FORMBOT/Marathon_UpdateManager/README.md

# Marathon Update Manager

  

Under this repository, the relevant files for successfully operating the Marathon IDEX 3D Printer are maintained and constantly updated.

- Klipper Configs
- Slicer Profiles
- Assembly and Operation Manual
- STL Files
- Official MODs and upgrades
- etc

By selecting 'update' for the 'Marathon' component from the 'Update Manager' in the Mainsail interface, all the components mentioned above will be updated and saved in the '0__Marathon' folder in your 'config' menu. 







## Enjoy and Happy Printing

Yours, Formbot Team ! :)

https://www.formbot3d.com/
