FORMBOT/Marathon_UpdateManager/2__Formbot_MODs/21__kTAMV_CXC/Mod_kTAMV_CXC___05062024.pdf

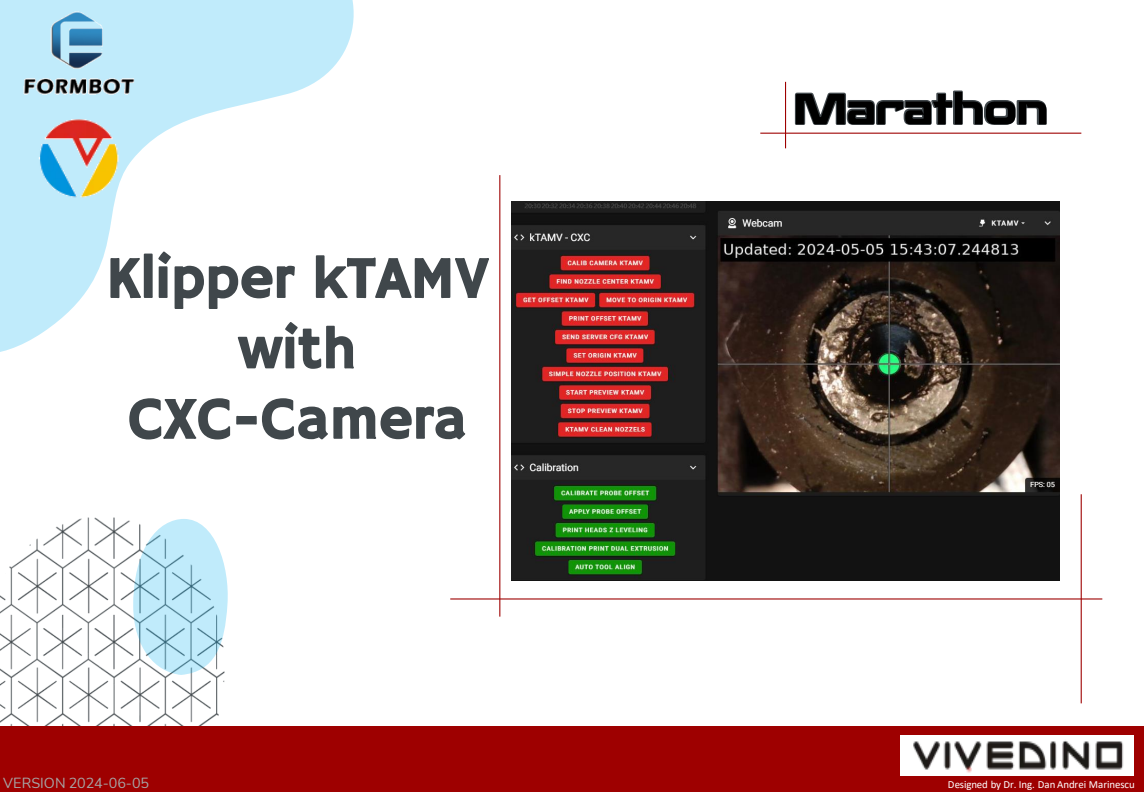
[picture p1: page 1]
VERSION 2024-06-05; Designed by Dr. Ing. Dan Andrei Marinescu; Klipper kTAMV with CXC-Camera

# Introduction

# Credits:

- CXC-Camera (https://emberprototypes.myshopify.com/products/emb02-cxc) → is an Assisted XY Calibration Tool from Ember Prototypes. (https://www.emberprototypes.com/) It was designed to be as simple and universal as possible and meant to be used on 3D printers with multiple printing heads.
- kTAMV (https://github.com/TypQxQ/kTAMV.git) → is a Klipper Alignment Tool designed by Andrei Ignat. (https://www.linkedin.com/in/andrei-ignat-718401b) It works by using Machine Vision and it allows the fully automatic calibration of nozzle offsets.
- This MOD → takes these two great products and put them together in the Marathon ecosystem.

## Why using CXC-Camera (https://emberprototypes.myshopify.com/products/emb02-cxc) ? Because … it is small … has LEDs … has a magnet … has an adjustable lens … has a long USB cable attached

… already had one laying around (as maybe some of you reading these rows also do)

## What this MOD actually is?

A highly precise and fully automatic calibration process for the XY offsets of the second printing head (T1) relative to the first one (T0).

## …and what it is not?

It is not a very fast process, it requires 6 minutes and 20 seconds to complete the calibration. However, it is significantly faster than printing multiple test model iterations.

## …. Can the calibration still be done manually?

Yes! There are only a few steps to follow. It is a process similar to what is required when using the original Windows App from Ember Prototypes.

## Known Bugs & ToDos:

-’The Auto Tool Align’ macro, when first used after a printer restart, is not aware of the Camera Calibration

## and Origin status, and it has to be restarted

-Sometimes the nozzle won’t be recognized, and the macro has to be restarted. | 1

## BOM

## - 1x CXC-Camera → https://www.emberprototypes.com/products/cxc

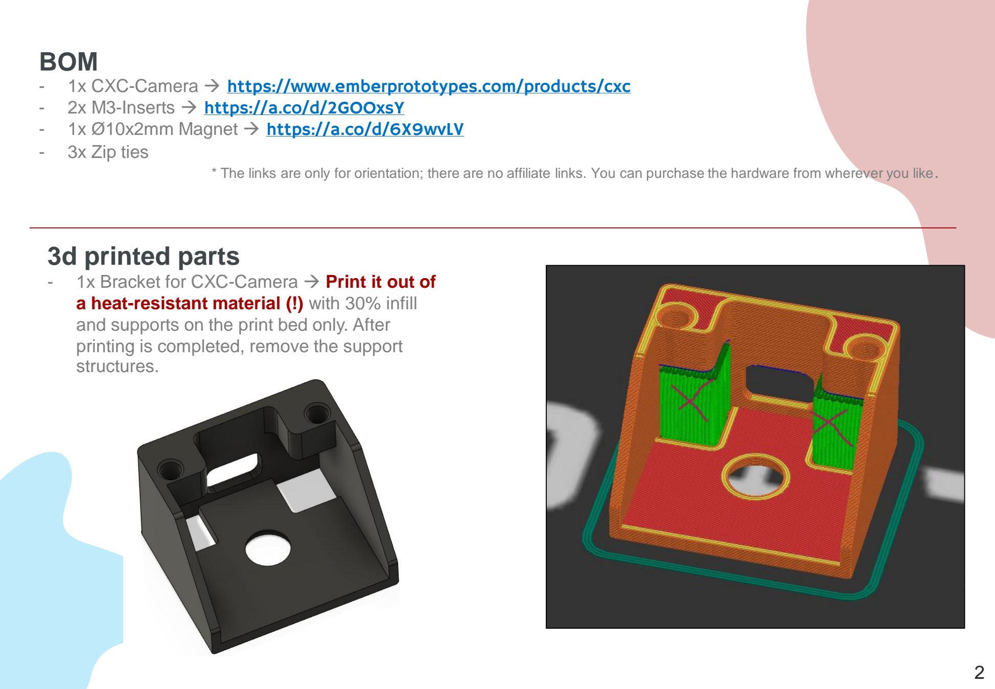
[picture p2: page 3]

## - 2x M3-Inserts → https://a.co/d/2GOOxsY - 1x Ø10x2mm Magnet → https://a.co/d/6X9wvLV

- 3x Zip ties
* The links are only for orientation; there are no affiliate links. You can purchase the hardware from wherever you like.

## 3d printed parts

- 1x Bracket for CXC-Camera → Print it out of a heat-resistant material (!) with 30% infill and supports on the print bed only. After printing is completed, remove the support structures.

## Prepare and Installation of the Bracket for the CXC-Camera

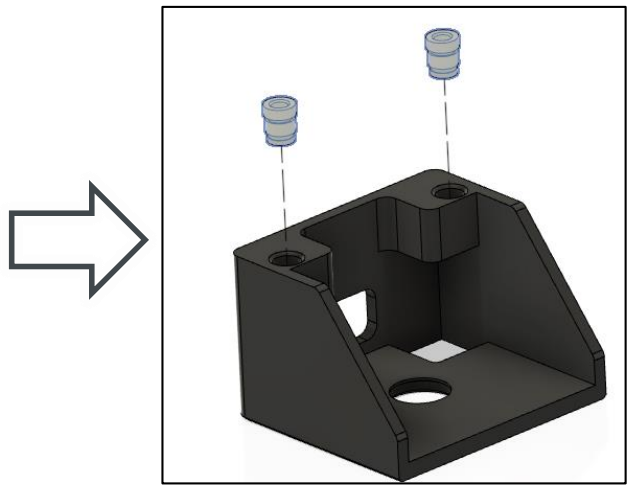
[picture p3: figure]
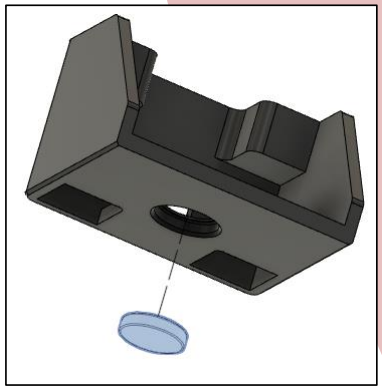
[picture p4: figure]

Install the two M3-Inserts and Ø10x2mm magnet as shown.
Make sure that the magnet orientation is such that it attracts the CXC-CAMERA !

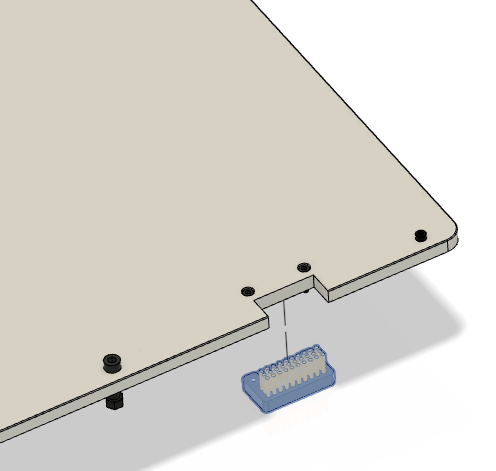
[picture p5: figure]
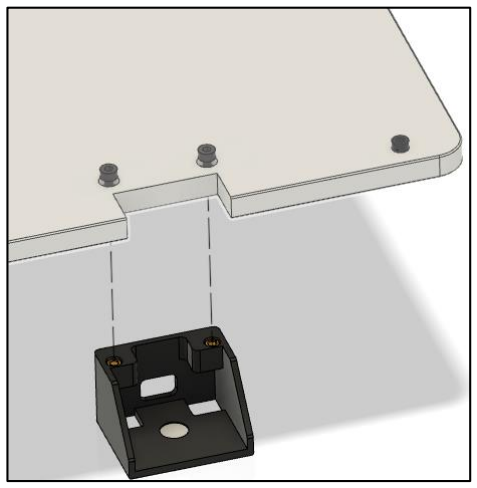
[picture p6: figure]

Remove the nozzle brush corresponding to T0 and install the Bracket for CXC-Camera in its place.
Recommendation: Keep the bed heated at 100°C for 10 minutes, and then retighten the screws holding the bracket.

## Cable management for the CXC-Camera

1

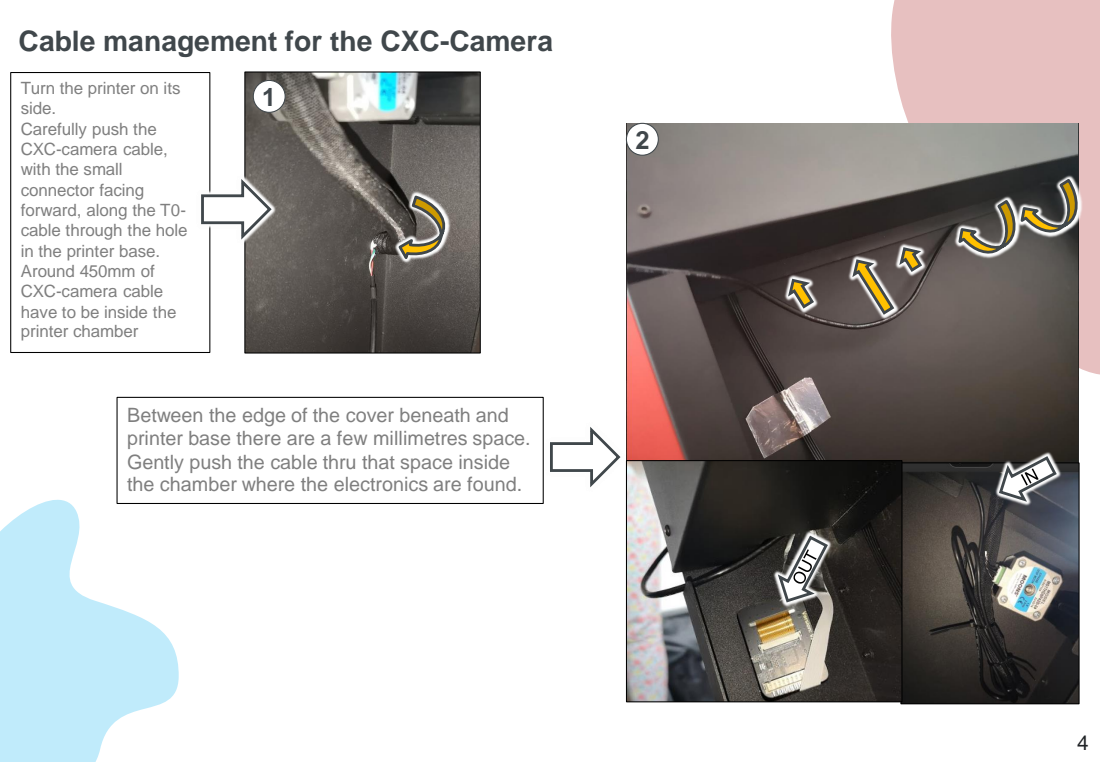
[picture p7: page 5]

Turn the printer on its
side.
Carefully push the
CXC-camera cable,
with the small
connector facing
forward, along the T0-
cable through the hole
in the printer base.
Around 450mm of
CXC-camera cable
have to be inside the
printer chamber

Between the edge of the cover beneath and
printer base there are a few millimetres space.
Gently push the cable thru that space inside
the chamber where the electronics are found.

## Cable management for the CXC-Camera

3

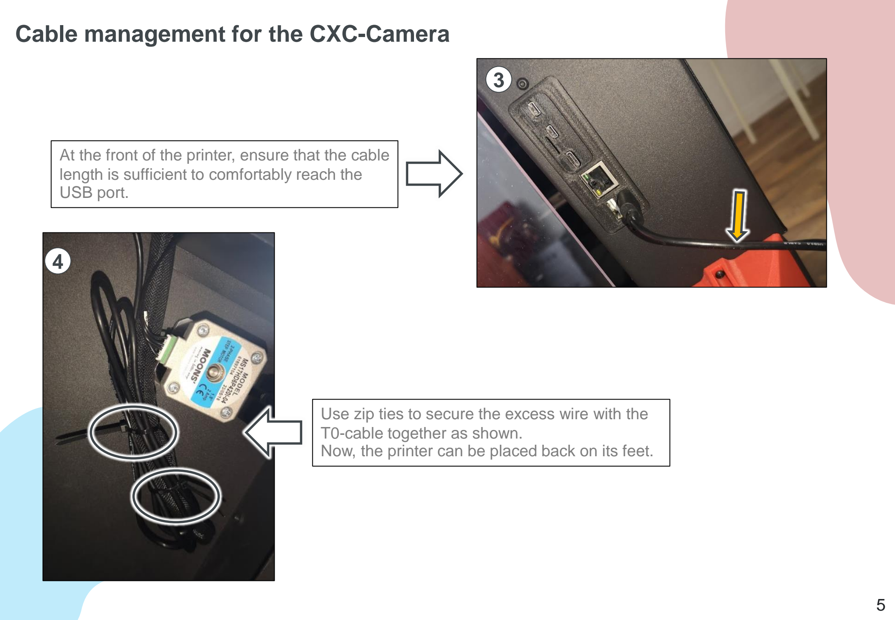
[picture p8: page 6]

At the front of the printer, ensure that the cable length is sufficient to comfortably reach the USB port.

Use zip ties to secure the excess wire with the T0-cable together as shown.
Now, the printer can be placed back on its feet.

4

## Cable management for the CXC-Camera

5

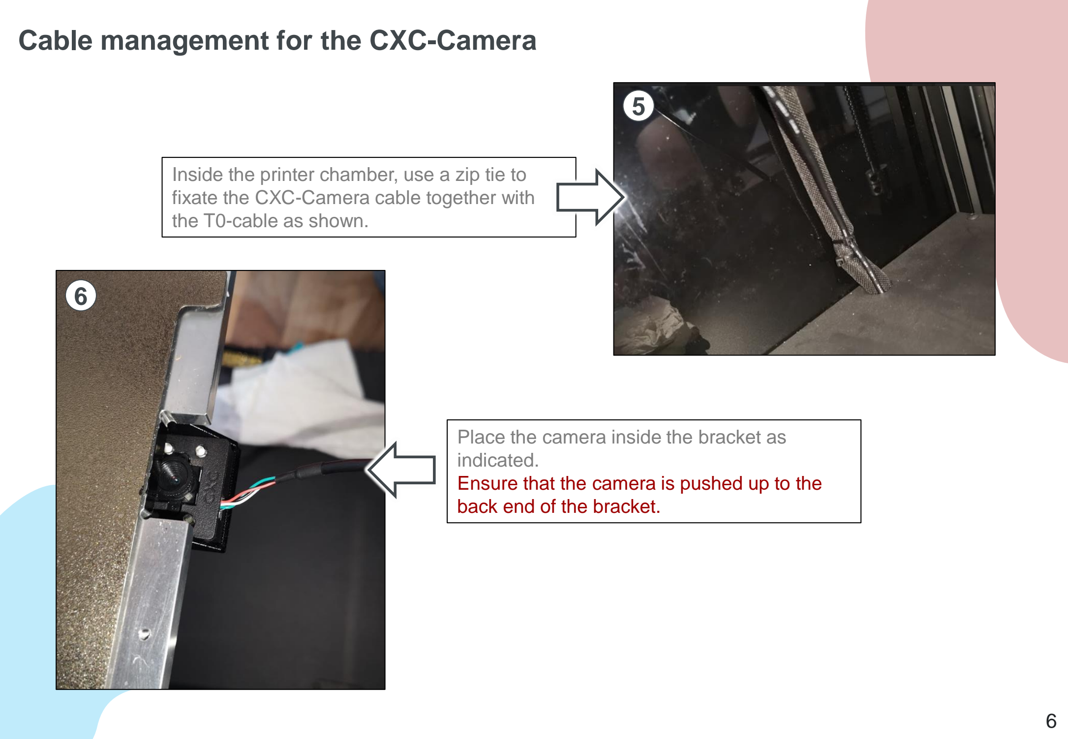
[picture p9: page 7]

Inside the printer chamber, use a zip tie to fixate the CXC-Camera cable together with the T0-cable as shown.

6

Place the camera inside the bracket as indicated.
Ensure that the camera is pushed up to the back end of the bracket.

## kTAMV Tool installation & Klipper configs

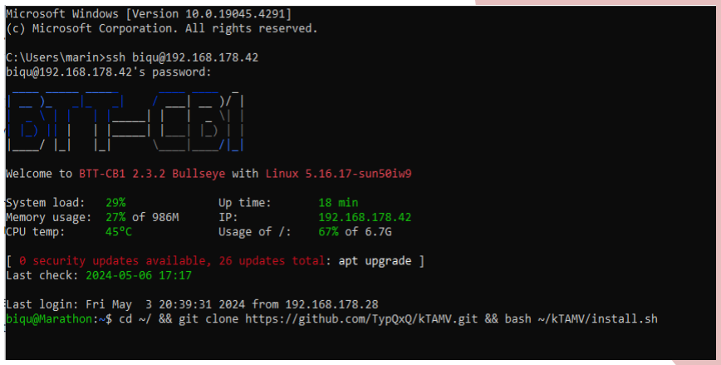
[picture p10: figure]

- Open a SSH
-connection to your printer. You can do that also from Windows Command Prompt
by typing: ssh biqu@<your printer IP> - | The password is ‘biqu’ if you haven’t change it. - | Type: cd ~/ && git clone

https://github.com/TypQxQ/kTAMV.git && bash ~/kTAMV/install.sh (https://github.com/TypQxQ/kTAMV.git%20&&%20bash%20~/kTAMV/install.sh)
- The installation will start, some question have to be answered with ‘yes’.
- During the installation your ‘printer.cfg’ and ‘moonraker.conf’ will be renamed and replaced by

new ones.
- A new file, ‘ktamv-macros.cfg’ will be added during installation to your machine
- Now some CFGs specific for Marathon have to be
added to your Machine: - | Upload the provided ‘ktamv_automation.cfg’
| and ‘variables.cfg ’
- Replace the ‘Marathon_Macros.cfg’ and ‘printer.cfg’ (The way the 'printer.cfg' resulting from

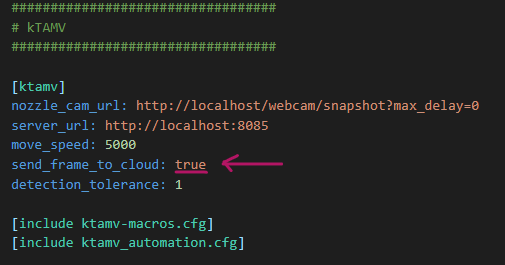
[picture p11: figure]

| the kTAMV installation is not okay, and some other settings have also been changed.)
- kTAMV is collecting data for future development, if you want to opt out, type ‘false’ in the indicated field inside ‘printer.cfg’ .

## kTAMV Tool installation & Klipper configs – Update Manager

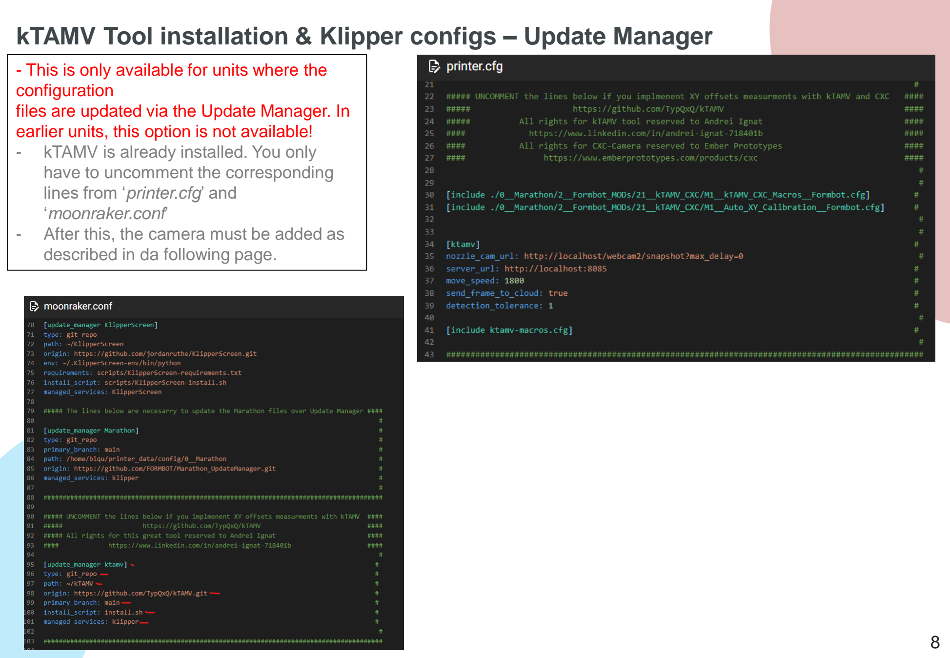
[picture p12: page 9]

- This is only available for units where the configuration
files are updated via the Update Manager. In earlier units, this option is not available!
- kTAMV is already installed. You only have to uncomment the corresponding lines from ‘printer.cfg’ and ‘moonraker.conf’
- After this, the camera must be added as described in da following page.

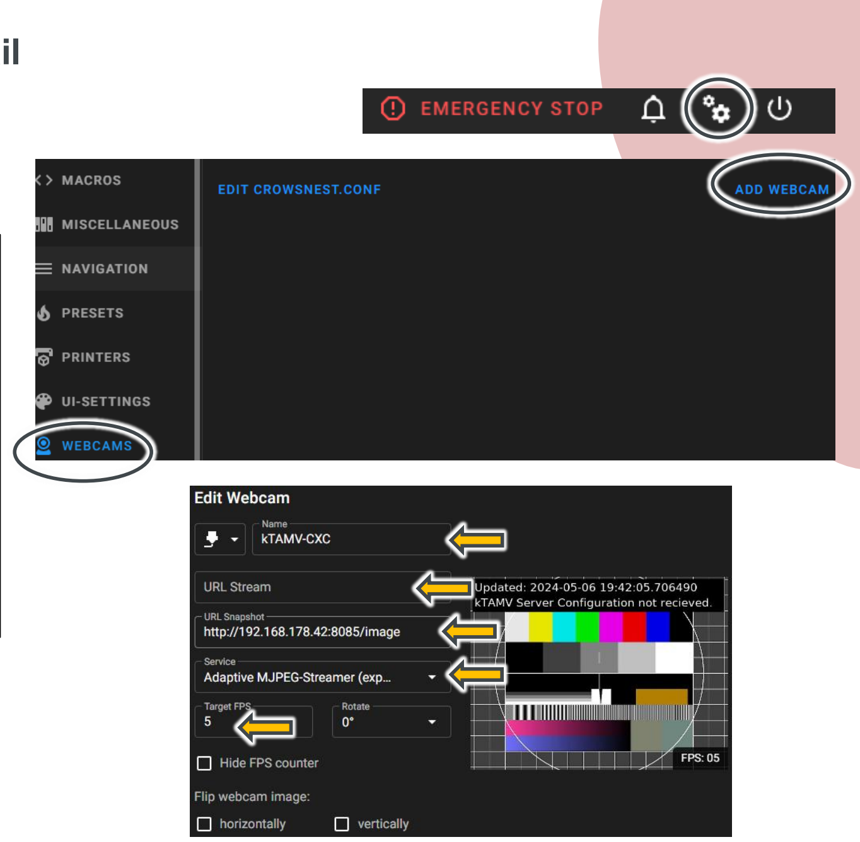
[picture p13: figure]

## Camera installation in Mainsail

- Plug in the USB-connector from the camera
- Go to ‘Interface Settings’
- Select ‘WEBCAMS’ menu
- Hit ‘ADD WEBCAM’
- Name the Camera as you prefer
- Leave ‘URL Stream’ empty
- In ‘URL Snapshot’ type: http://<your printer IP>:8085/image
- For ‘Service’ use ‘Adaptive MJPEG’
- 4-5 FPS are enough
- Power the printer OFF and than back ON from the button from behind.

## kTAMV Macros

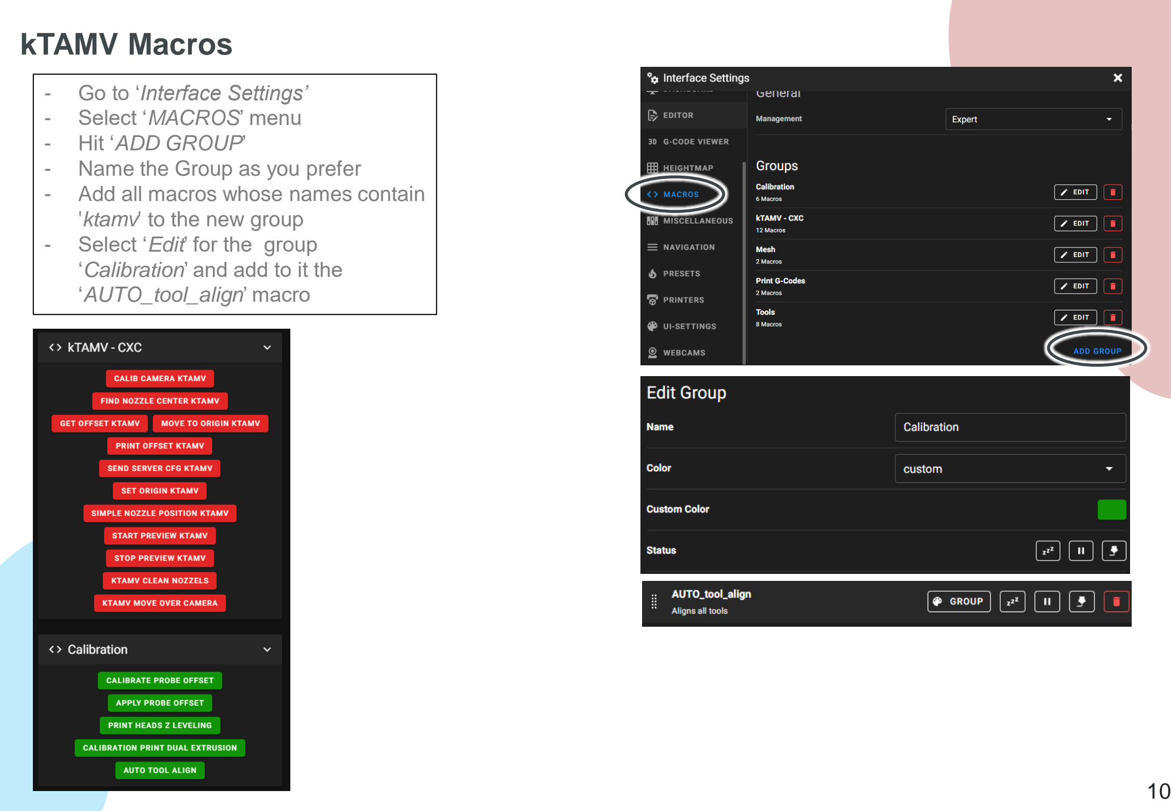
[picture p14: page 11]

- Go to ‘Interface Settings’
- Select ‘MACROS’ menu
- Hit ‘ADD GROUP’
- Name the Group as you prefer
- Add all macros whose names contain 'ktamv' to the new group
- Select ‘Edit’ for the group ‘Calibration’ and add to it the ‘AUTO_tool_align’ macro

## kTAMV Macros

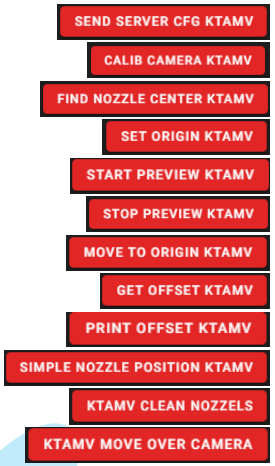
[picture p15: figure]

It sends the camera configurations to the server where kTAMV runs

It makes camera calibration, it determines the number of pixels per millimetre

It finds the nozzle centre

It sets the origin to which the next tool/tools will be calibrated

Turns the image on

Turns the image off

Moves the selected tool to the last saved origin

Measures the offsets of the selected tool relative to the saved origin

It displays in the console the offsets that were just measured

Basically checks if the camera is able to recognize the nozzle

Heats the nozzles and brush them (Marathon specific Macro)

Move the selected print head over the CXC-Camera (Marathon specific Macro)

It makes the whole determination of the T1 offsets relative to T0 automatically and saves the results in ‘variables.cfg’ ( is an adaptation of ‘ktamv_automation_example.cfg’ Macro from kTAMV made for Marathon )

## Adjust CXC Camera Lens

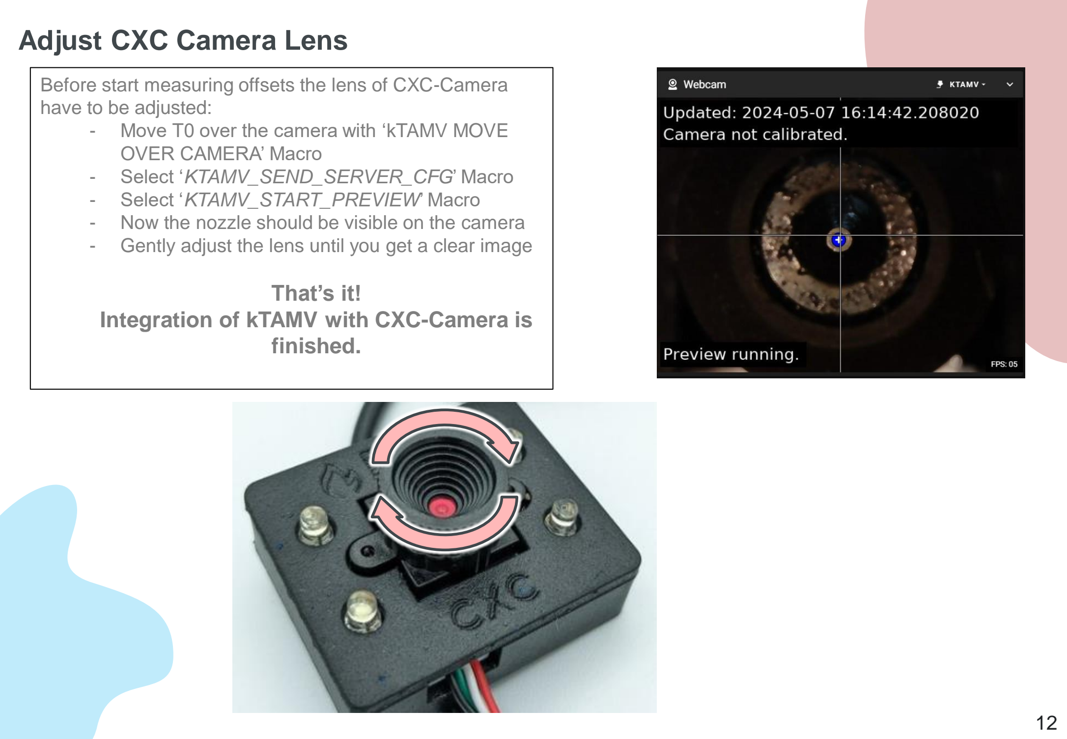
[picture p16: page 13]

Before start measuring offsets the lens of CXC-Camera have to be adjusted:
- Move T0 over the camera with ‘kTAMV MOVE OVER CAMERA’ Macro
- Select ‘KTAMV_SEND_SERVER_CFG’ Macro
- Select ‘KTAMV_START_PREVIEW’ Macro
- Now the nozzle should be visible on the camera
- Gently adjust the lens until you get a clear image

That’s it!
Integration of kTAMV with CXC-Camera is finished.

## Thoughts and concerns …

Exposure to heat → On Marathon, the CXC-
Camera has no direct contact with the bed but is exposed to radiant heat emanating from it. Theoretically, cameras like the CXC should be fine up to 70°C. However, if there are concerns about heat exposure, when not in use, the camera can be parked somewhere

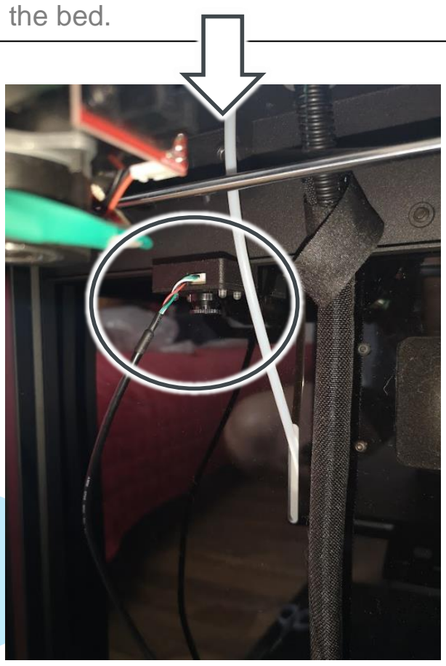
[picture p17: figure]

away from the bed.

Constantly ON → "I have no data on whether keeping the camera constantly on would prematurely wear it out. However, if there are concerns about the effects on the camera from being constantly kept on, the USB connector can be unplugged and it can be parked aside, resting on a magnet.

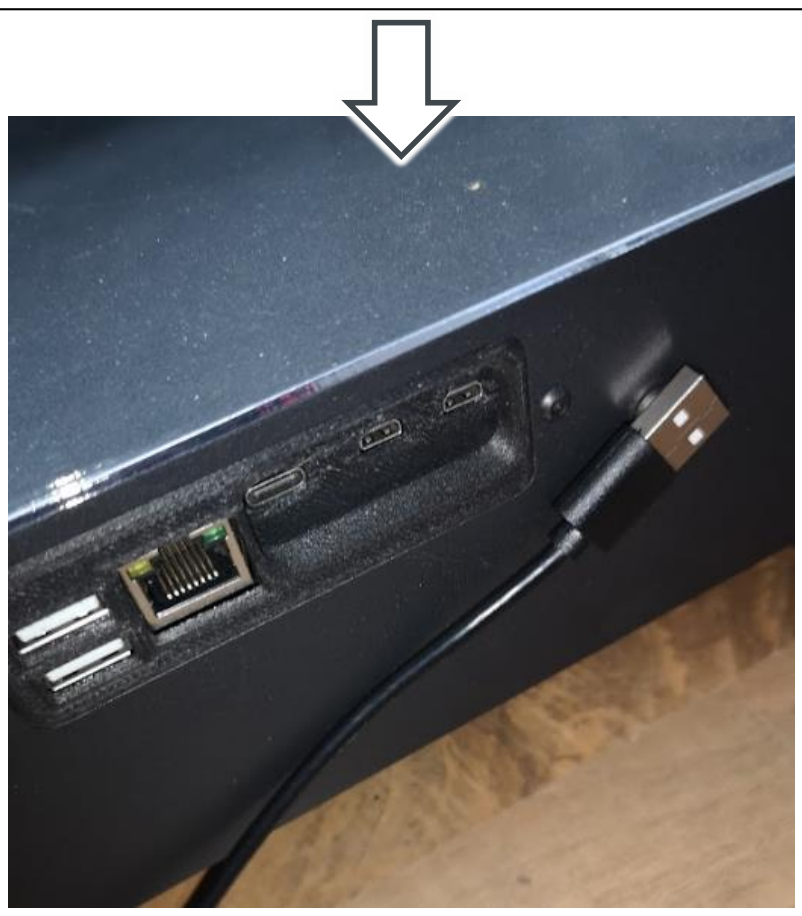
[picture p18: figure]

## Measuring the Offsets manually

kTAMV is very particular and picky when it comes to the cleanliness of the nozzles. The nozzles have to be perfectly clean in order to be detected by the kTAMV.

The measuring of the XY offsets from T1 can also be done manually in a manner very similar to the original Windows app from Ember Prototypes.

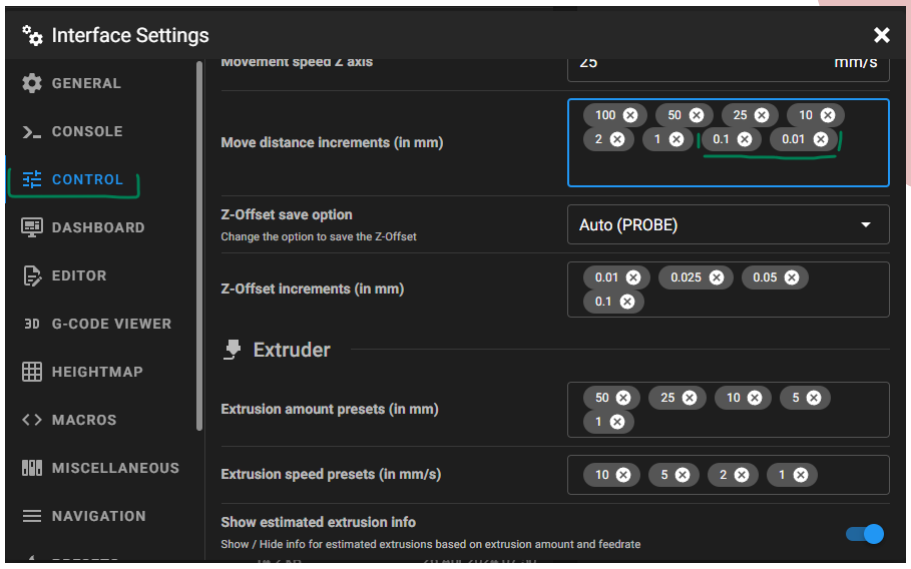
[picture p19: figure]

Make sure that in interface you have small increments:

## Measuring the Offsets manually

Make yourself an extra Macro Group like described. Execute in order the following steps to measure manually the offsets from T1:

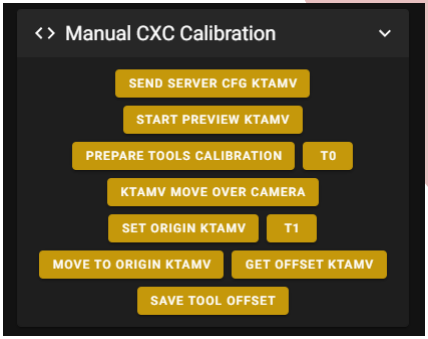
[picture p20: figure]

1. Execute ‘SEND SERVER CFG KTAMV’

→ it wakes up
the kTAMV Server
2. Execute ‘START PREVIEW KTAMV’

→ it opens the
camera
3. Execute ‘PREPARE TOOLS CALIBRATIONS’

→ it
cleans the tools, deletes the old offsets and position T0 over the camera
4. Move T0 from the interface until it is perfectly centred to the camera
5. Execute ‘SET ORIGIN KTAMV’

→ it sets the origin to
which the offsets from T1 will be measured
6. Select T1
7. Execute ‘MOVE TO ORIGIN KTAMV’

→ moves the
selected tool to origin (in this case T1

)
8. Move T1 from the interface until it is perfectly centred to the camera
9. Execute ‘GET OFFSET KTAMV’

→ it calculates the
offsets of the current tool relative to the saved Origin
10. Execute ‘SAVE TOOL OFFSET
’

→ it saves the offsets
in ‘variables.cfg
’

That is it !

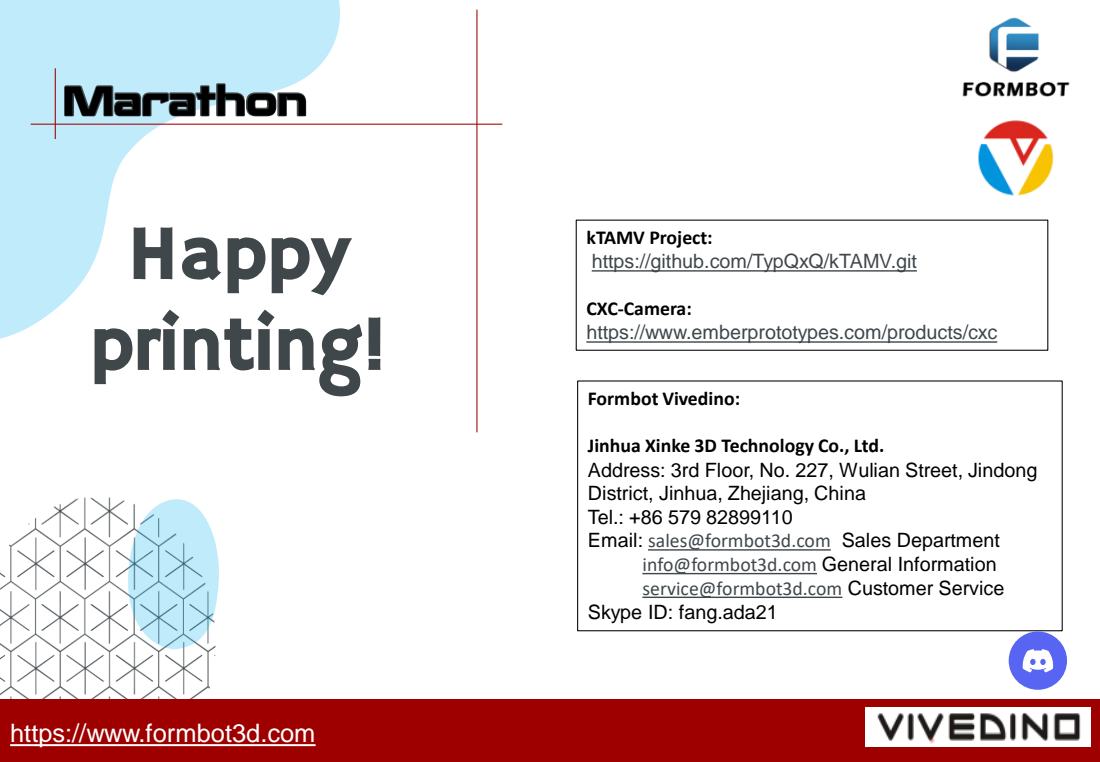
[picture p21: page 17]
Happy printing!; Formbot Vivedino:

kTAMV Project:
https://github.com/TypQxQ/kTAMV.git

CXC-Camera:
https://www.emberprototypes.com/products/cxc

Jinhua Xinke 3D Technology Co., Ltd.
Address: 3rd Floor, No. 227, Wulian Street, Jindong
District, Jinhua, Zhejiang, China
Tel.: +86 579 82899110
Email: sales@formbot3d.com Sales Department
info@formbot3d.com General Information
service@formbot3d.com Customer Service
Skype ID: fang.ada21

https://www.formbot3d.com
