FORMBOT/Marathon_UpdateManager/2__Formbot_MODs/23__MB_Fan/Mod_MB_Controlles_Fan____22062024.pdf

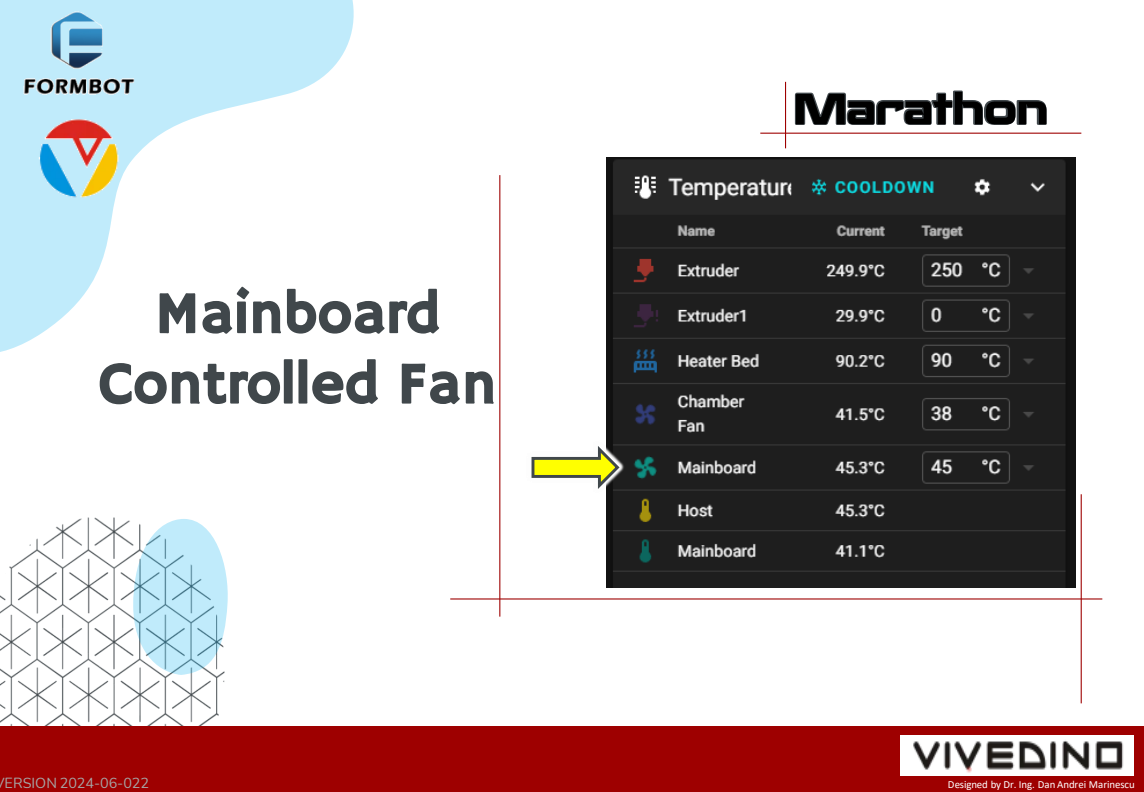
[picture p22: page 1]
VERSION 2024-06-022; Designed by Dr. Ing. Dan Andrei Marinescu; Mainboard Controlled Fan

# Introduction

# Motivation

The mainboard fan is by default always on, even when there is no printing job ongoing. As a result, the machine is unnecessarily noisy when idle.

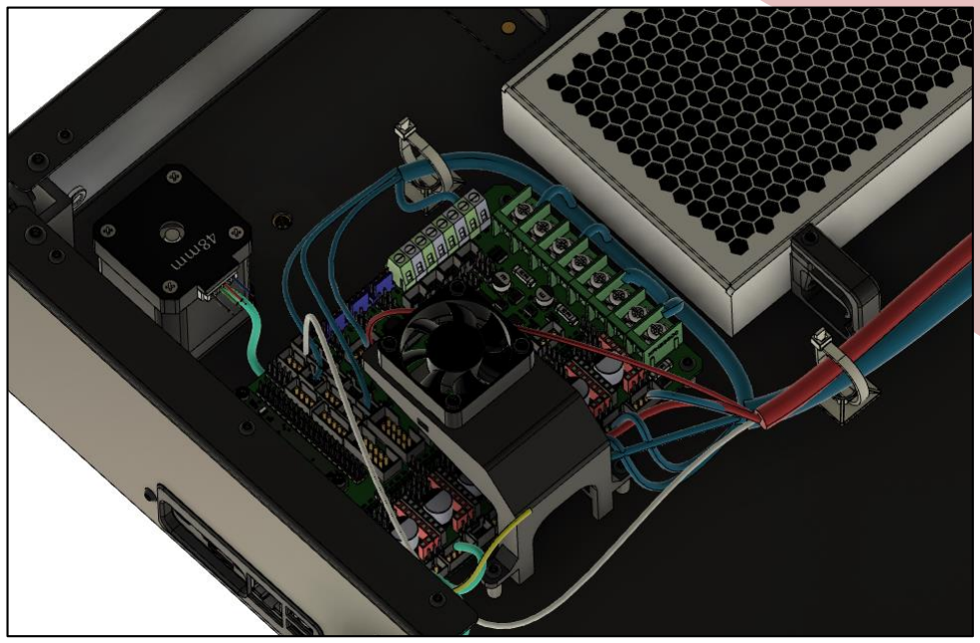
[picture p23: figure]

# Pros: It reduces the overall noise of the printer, making it completely silent when

idle.

# Cons: couldn’t find any…

## BOM

- Some 24 gauge wires.
- Cable End Sleeves

## 3d printed parts

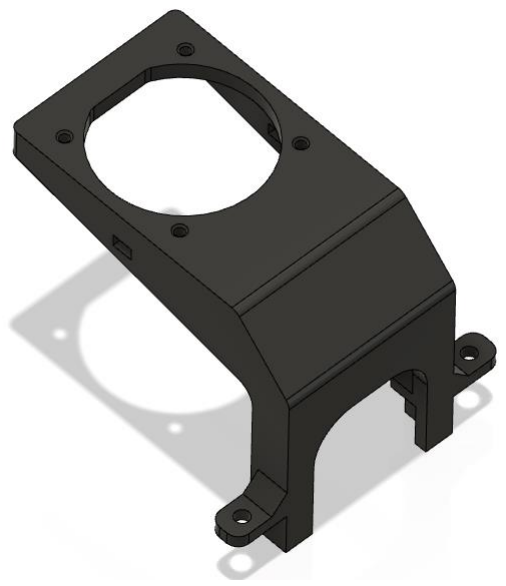
[picture p24: figure]

- 1x Bracket for the fan → with 30% infill, no supports. Chose the material and color you like.

* Print this part only if your printer doesn’t have it, in the early units was another type of bracket installed.

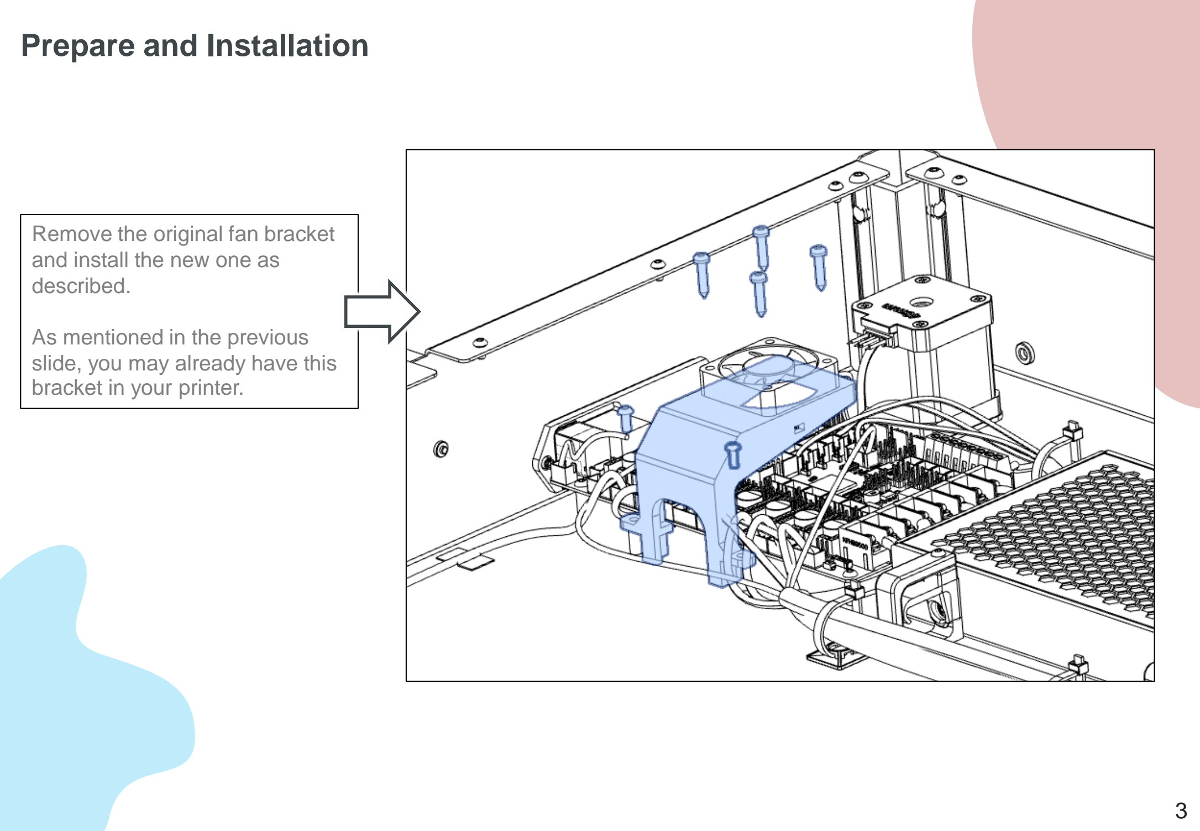
[picture p25: figure]
Prepare and Installation; Remove the original fan bracket and install the new one as described.; As mentioned in the previous slide, you may already have this bracket in your printer.

2

3

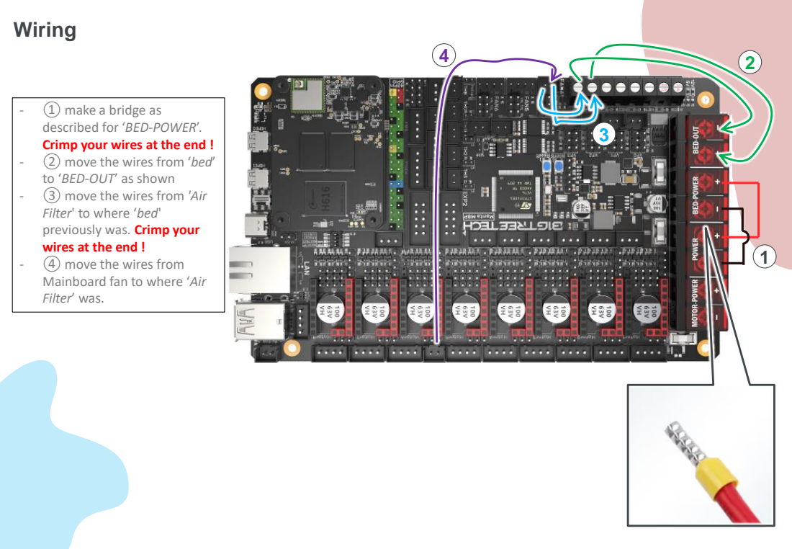
[picture p26: page 5]
Wiring -; ① make a bridge as; -POWER’.

described for ‘BED
Crimp your wires at the end !
② move the wires from ‘bed’
to ‘BED
③ move the wires from 'Air
Filter' to where ‘bed'
previously was. Crimp your
wires at the end !
④ move the wires from
Mainboard fan to where ‘Air
Filter’ was.

-OUT’ as shown

## Software settings

Go in ‘Marathon_BTT_M8P-V1.1.cfg’ and make the following changes:

- Change the heater pin for the bed: [heater_bed]
heater_pin:PB7
- Change the pin for the chamber fan: [temperature_fan chamber_fan] pin:PE1

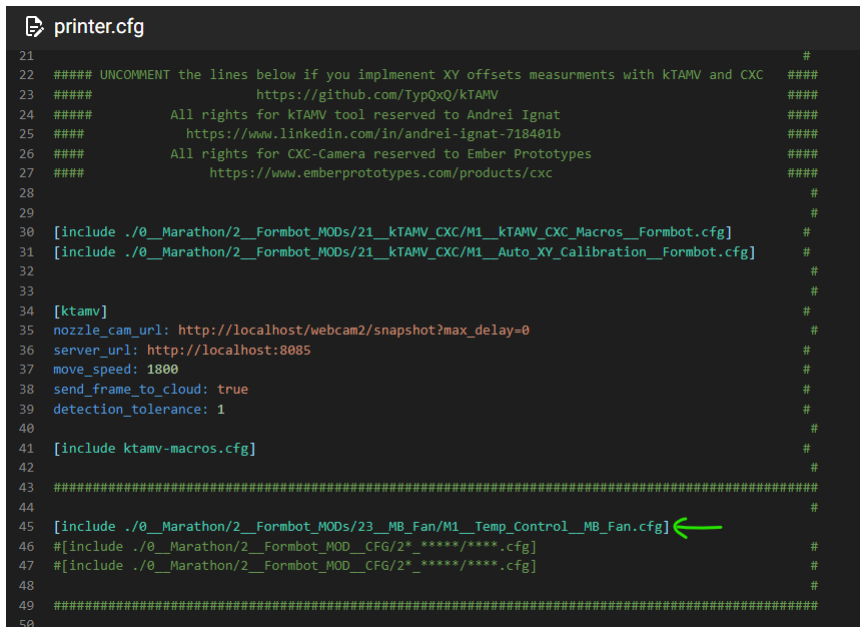
[picture p27: figure]

Add the following config section for the mainboard fan:

[temperature_fan Mainboard] pin:PE4
max_power:1.0
control:watermark
max_delta:2
sensor_type:temperature_host min_temp:0
max_temp:65
target_temp:45

If your running the new image where everything is updated via ‘Update Manager’:

- Make sure that you have all the Klipper components updated.
- Add this line in your printer.cfg in MODs CFG section

[include
./0__Marathon/2__Formbot_MODs/23__MB_Fan/M1__Temp_Cont rol__MB_Fan.cfg]

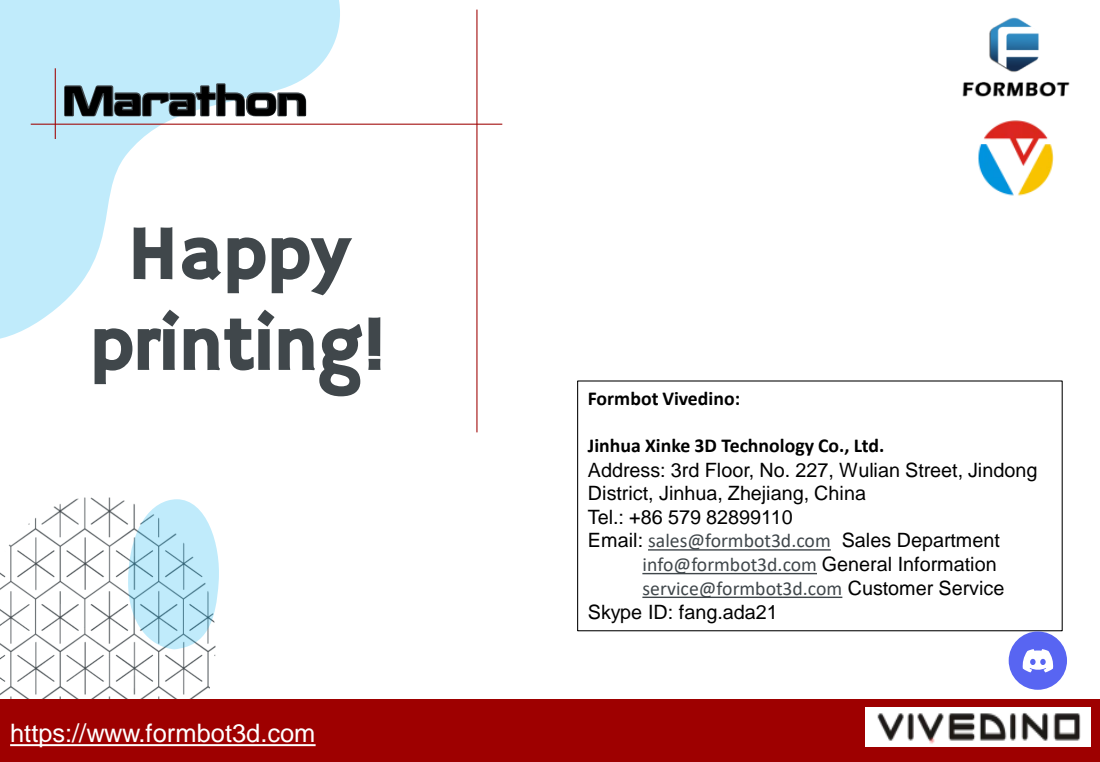
[picture p28: page 7]
Happy printing!; Formbot Vivedino:

Jinhua Xinke 3D Technology Co., Ltd.
Address: 3rd Floor, No. 227, Wulian Street, Jindong
District, Jinhua, Zhejiang, China
Tel.: +86 579 82899110
Email: sales@formbot3d.com Sales Department
info@formbot3d.com General Information
service@formbot3d.com Customer Service
Skype ID: fang.ada21

https://www.formbot3d.com
