FORMBOT/Marathon_UpdateManager/2__Formbot_MODs/22__BTT_HDMI5/Mod_BTT_HDMI5____07062024.pdf

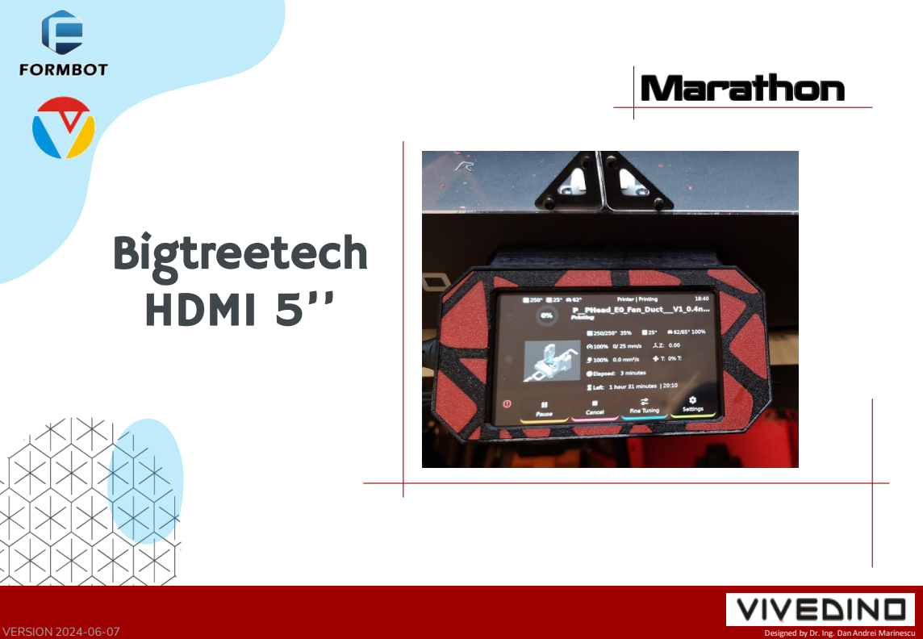
[picture p29: page 1]
VERSION 2024-06-07; Designed by Dr. Ing. Dan Andrei Marinescu; Bigtreetech HDMI 5’’

# Introduction

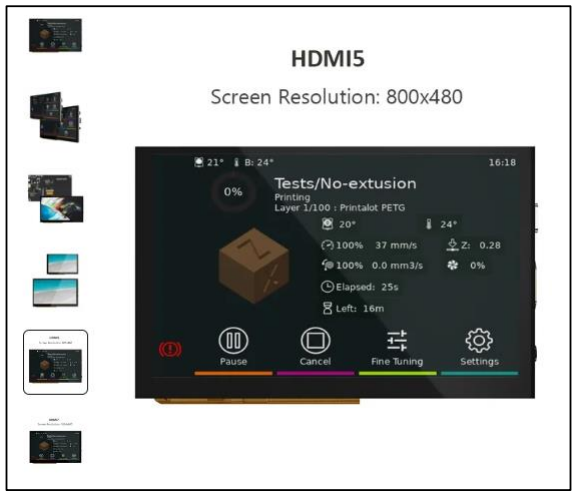
[picture p30: figure]

## https://a.aliexpress.com/_EzKYAax

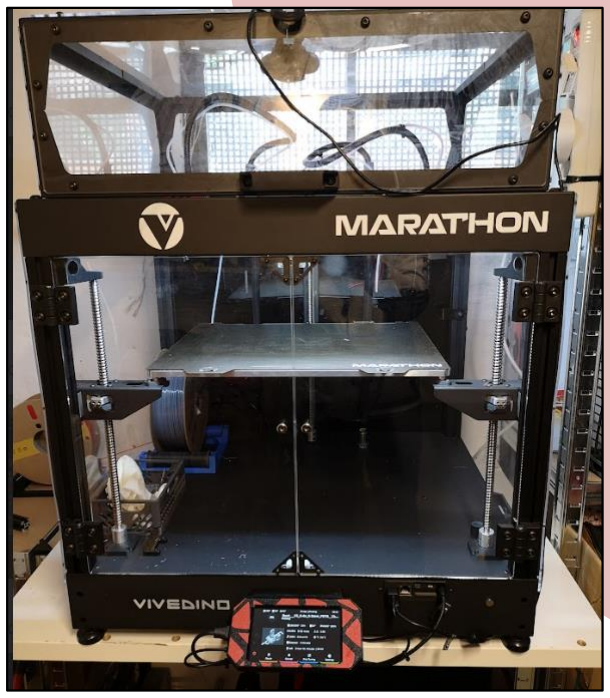
[picture p31: figure]

# Motivation

Klipper printers mainly rely on the Mainsail interface for controlling the printer. Marathon printers come standard equipped with an SPI display that allows for control of the printer and offline printing via USB stick, completely independent of the Mainsail interface.

The SPI display is relatively small, and its performance is modest. Some users would like to have a more robust solution when it comes to the display controller.

HDMI displays from Bigtreetech are perfectly compatible with Marathon electronics since they are also from Bigtreetech.

# Pros: Improved user experience Cons: You end up with some cables in plain sight

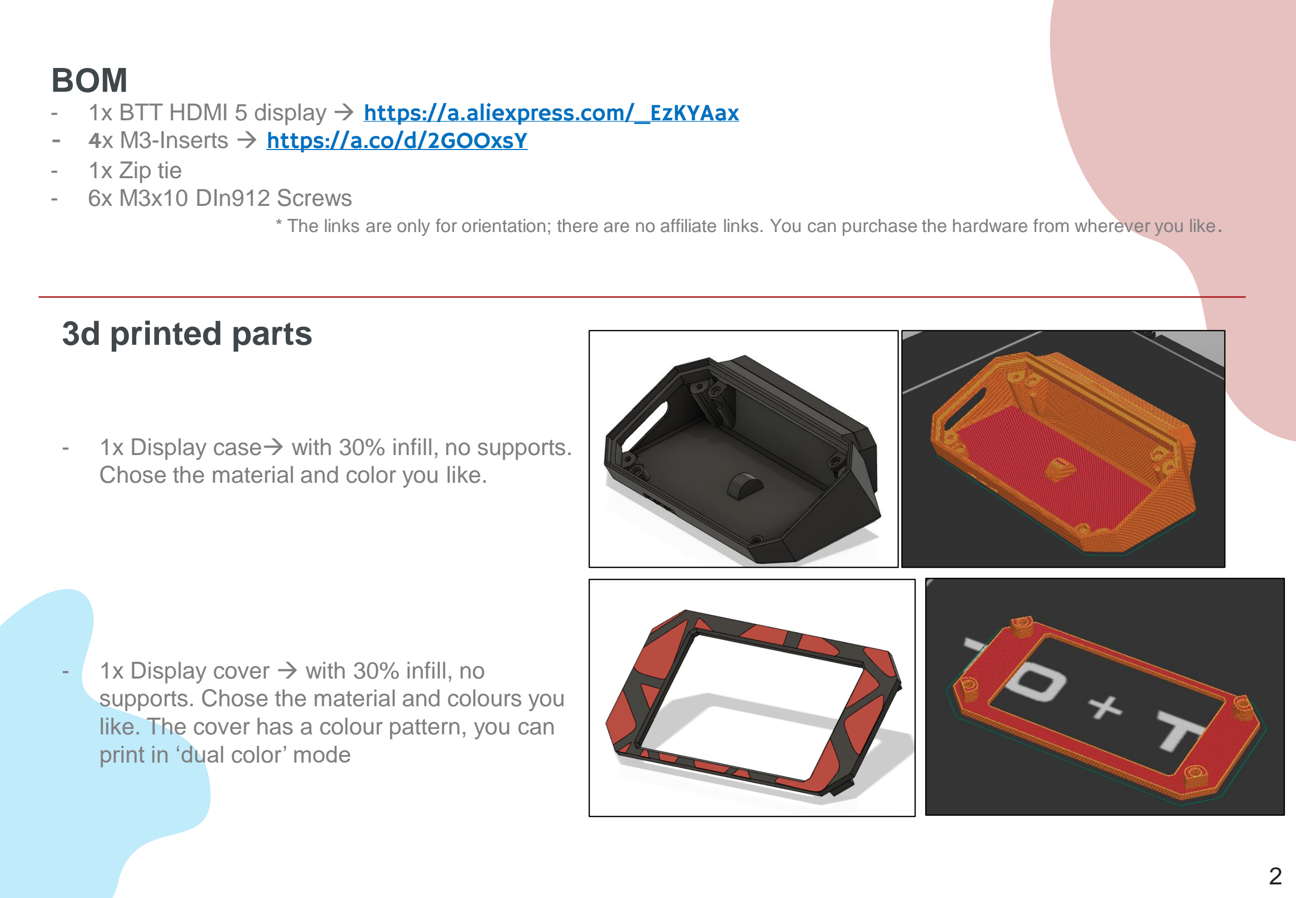
[picture p32: figure]
BOM; - 1x Zip tie - 6x M3x10 DIn912 Screws; 3d printed parts; Chose the material and color you like.; print in ‘dual color’ mode

## - 1x BTT HDMI 5 display → https://a.aliexpress.com/_EzKYAax - 4x M3-Inserts → https://a.co/d/2GOOxsY

* The links are only for orientation; there are no affiliate links. You can purchase the hardware from wherever you like.

- 1x Display case→ with 30% infill, no supports.
- 1x Display cover → with 30% infill, no supports. Chose the material and colours you like. The cover has a colour pattern, you can

## Prepare and Installation

1

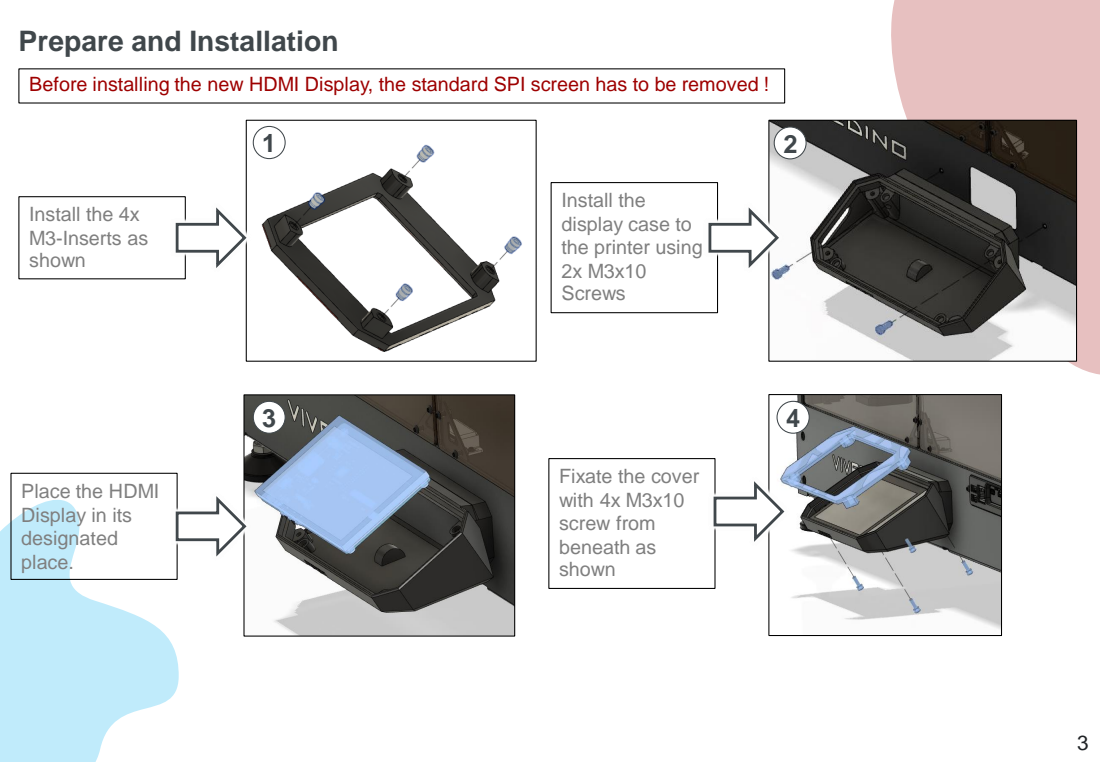
[picture p33: page 4]
Install the 4x M3-Inserts as shown

Before installing the new HDMI Display, the standard SPI screen has to be removed !

Install the
display case to
the printer using
Screws

Fixate the cover
with 4x M3x10
screw from
beneath as
shown

Place the HDMI
Display in its
designated
place.

## Cables connection

s

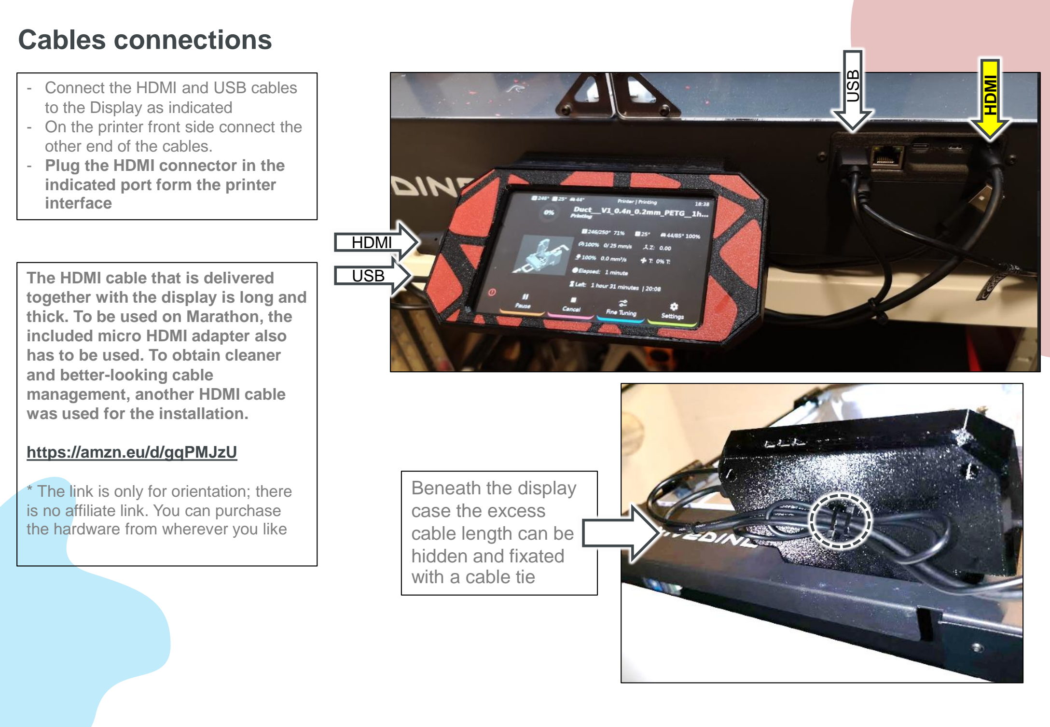
[picture p34: page 5]

HDMI

USB

USB

HDMI

- Connect the HDMI and USB cables to the Display as indicated
- On the printer front side connect the other end of the cables.
- Plug the HDMI connector in the indicated port form the printer interfac

e

The HDMI cable that is delivered together with the display is long and thick. To be used on Marathon, the included micro HDMI adapter also has to be used. To obtain cleaner and better

-looking cable
management, another HDMI cable was used for the installation.

https://amzn.eu/d/gqPMJzU

* The link is only for orientation; there is no affiliate link. You can purchase the hardware from wherever you like

Beneath the display
case the excess
cable length can be
hidden and fixated
with a cable tie

## Software settings

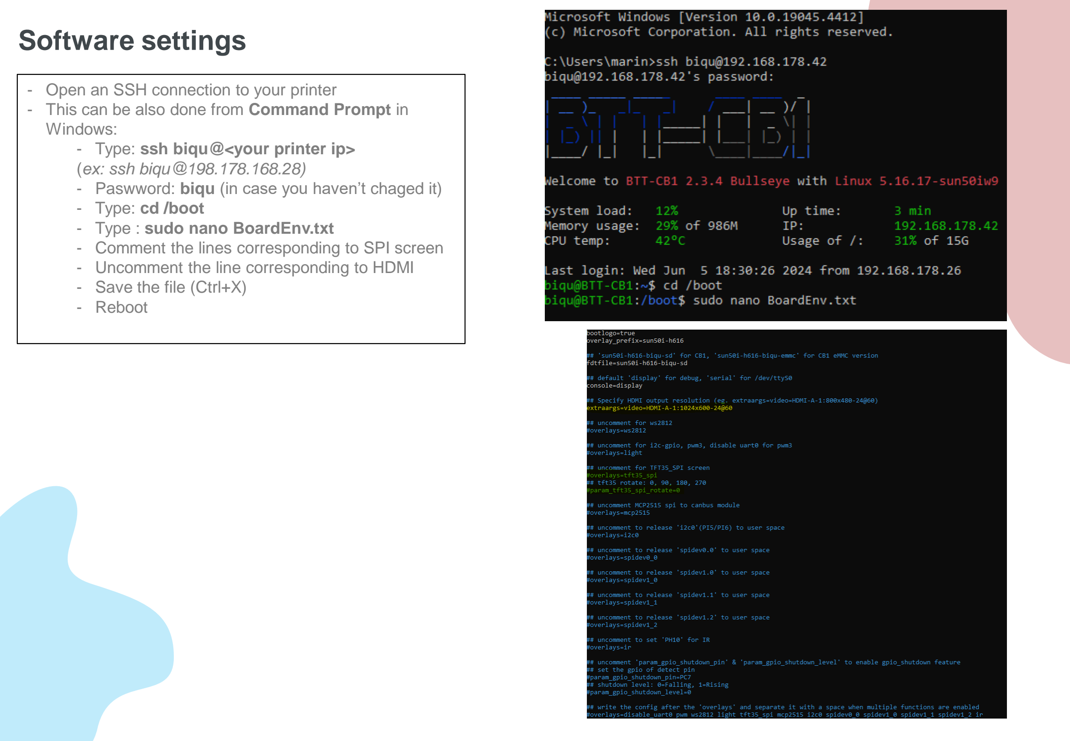
[picture p35: page 6]

- Open an SSH connection to your printer
- This can be also done from Command Prompt in Windows:
- Type: ssh biqu@<your printer ip>
(ex: ssh biqu@198.178.168.28)
- Paswword: biqu (in case you haven’t chaged it)
- Type: cd /boot
- Type : sudo nano BoardEnv.txt
- Comment the lines corresponding to SPI screen
- Uncomment the line corresponding to HDMI
- Save the file (Ctrl+X)
- Reboot

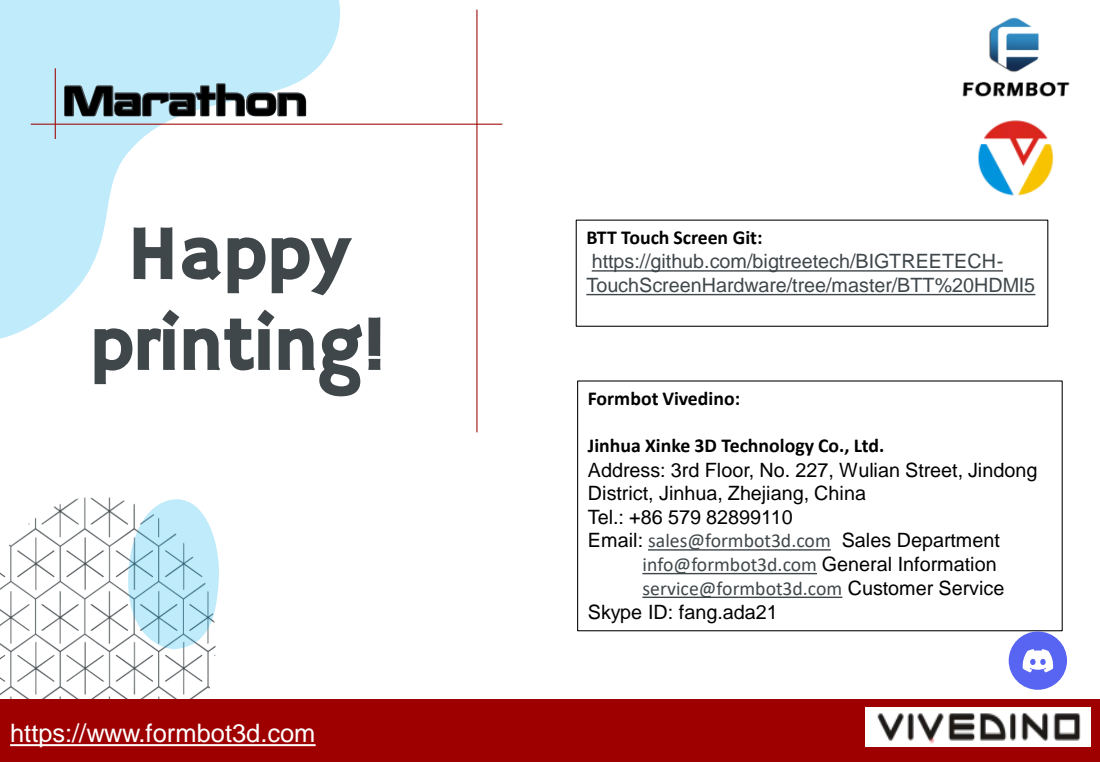
[picture p36: page 7]
Happy printing!; Formbot Vivedino:

BTT Touch Screen Git:
https://github.com/bigtreetech/BIGTREETECH-
TouchScreenHardware/tree/master/BTT%20HDMI5

Jinhua Xinke 3D Technology Co., Ltd.
Address: 3rd Floor, No. 227, Wulian Street, Jindong
District, Jinhua, Zhejiang, China
Tel.: +86 579 82899110
Email: sales@formbot3d.com Sales Department
info@formbot3d.com General Information
service@formbot3d.com Customer Service
Skype ID: fang.ada21

https://www.formbot3d.com
