FORMBOT/Marathon_UpdateManager/2__Formbot_MODs/23__MB_Fan/M1B__Fix_Fan_Mainboard___V2.0 v6.step

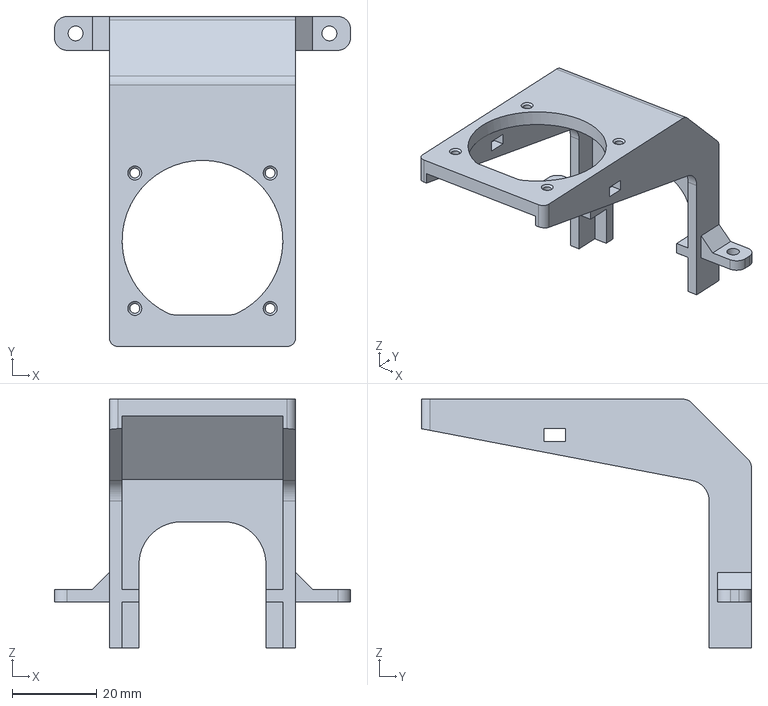
[picture p37: CAD file, 2024-06-22]
2__Formbot_MODs/23__MB_Fan/M1B__Fix_Fan_Mainboard___V2.0 v6.step
70.0 x 78.0 x 58.8 mm
