FORMBOT/Marathon_UpdateManager/2__Formbot_MODs/21__kTAMV_CXC/025_01__MB1__Fix_CXC_Bed___V1.0 v17.step

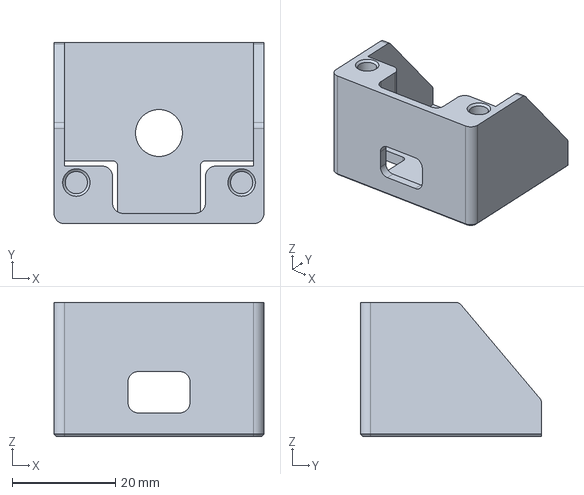
[picture p38: CAD file, 2024-05-28]
2__Formbot_MODs/21__kTAMV_CXC/025_01__MB1__Fix_CXC_Bed___V1.0 v17.step
40.6 x 35.1 x 26.0 mm
