FORMBOT/Marathon_UpdateManager/3__Formbot_SlicerProfiles/31__PrusaSlicer/01_01082024/printer/STL_Marathon_BED_Mono_Dual.stl

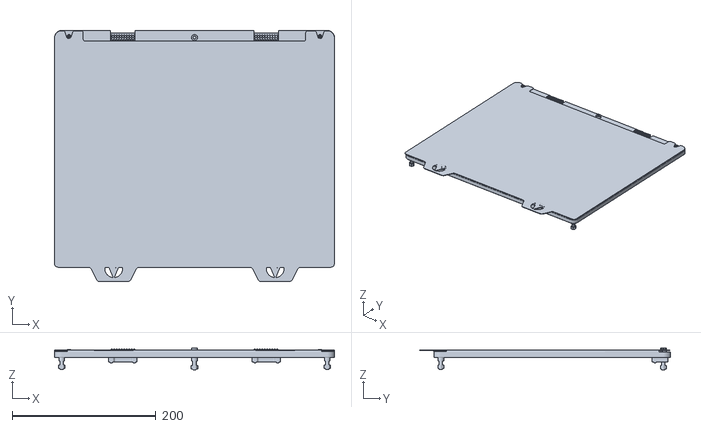
[picture p39: CAD file, 2024-05-28]
3__Formbot_SlicerProfiles/31__PrusaSlicer/01_01082024/printer/STL_Marathon_BED_Mono_Dual.stl
390.1 x 350.0 x 30.0
