FORMBOT/Marathon_UpdateManager/5__Formbot__Usefull_3Ds/50__Marathon_STLs/M1B_Fix_Wipe_Plate_Nozzle_Left__V2.0 v2.stl

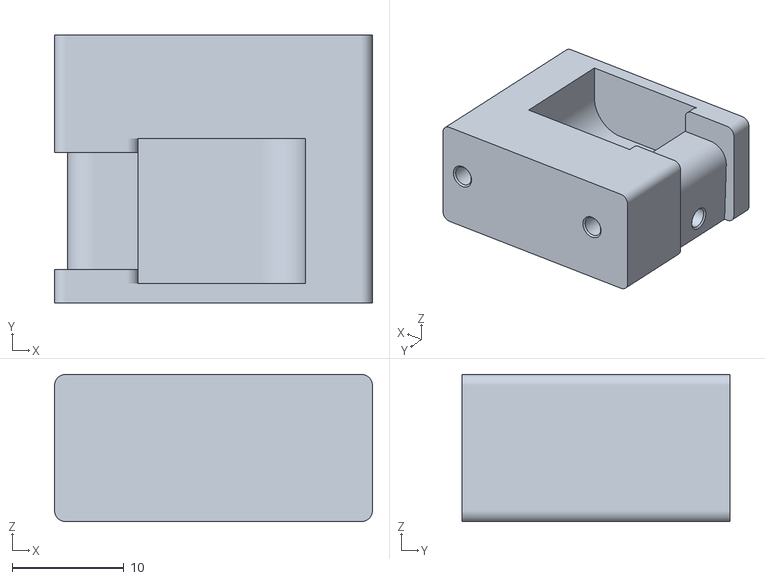
[picture p40: CAD file, 2024-05-28]
5__Formbot__Usefull_3Ds/50__Marathon_STLs/M1B_Fix_Wipe_Plate_Nozzle_Left__V2.0 v2.stl
28.5 x 24.0 x 13.2
