FORMBOT/Marathon_UpdateManager/5__Formbot__Usefull_3Ds/51__Spool_Holder/Spool_Holder_Body_2___V1.stl

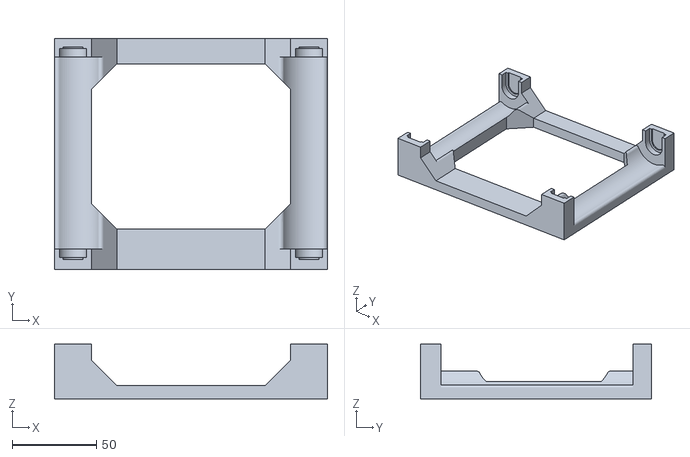
[picture p41: CAD file, 2024-05-28]
5__Formbot__Usefull_3Ds/51__Spool_Holder/Spool_Holder_Body_2___V1.stl
162.0 x 137.0 x 32.5
