FORMBOT/Marathon_UpdateManager/3__Formbot_SlicerProfiles/31__PrusaSlicer/01_01082024/printer/STL_Marathon_BED_Copy.stl

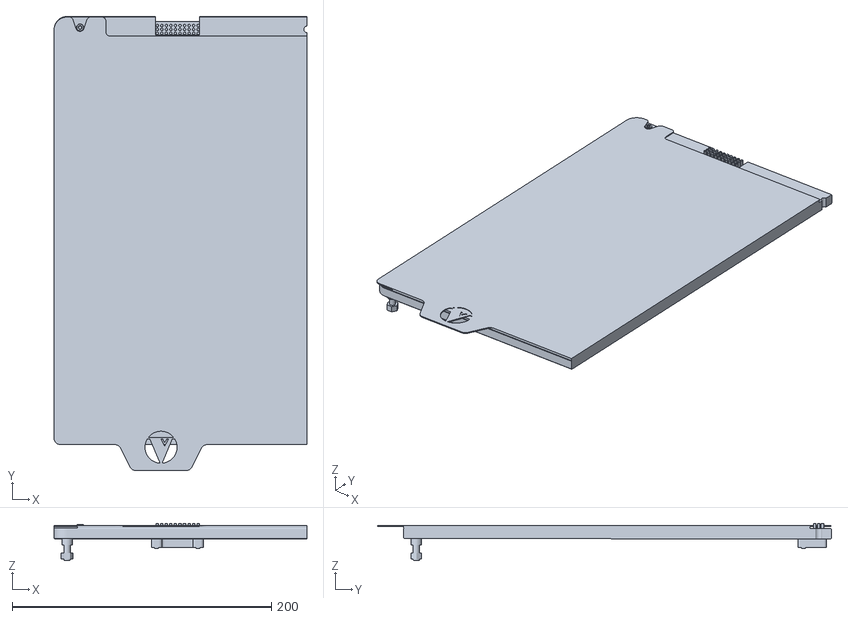
[picture p42: CAD file, 2024-05-28]
3__Formbot_SlicerProfiles/31__PrusaSlicer/01_01082024/printer/STL_Marathon_BED_Copy.stl
195.0 x 350.0 x 28.6
