FORMBOT/Marathon_UpdateManager/5__Formbot__Usefull_3Ds/50__Marathon_STLs/M1B_Fix_Bearing_GE5C___V1.0 v2.stl

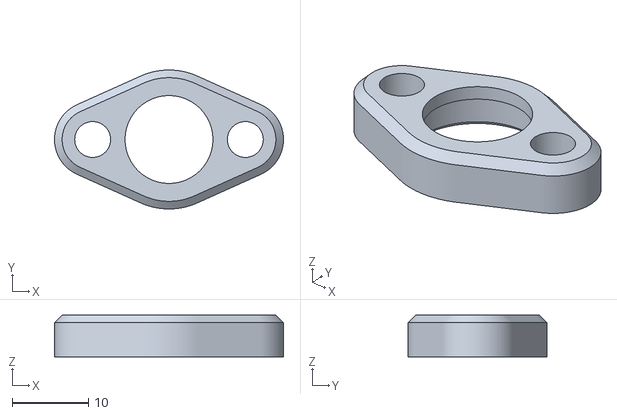
[picture p43: CAD file, 2024-05-28]
5__Formbot__Usefull_3Ds/50__Marathon_STLs/M1B_Fix_Bearing_GE5C___V1.0 v2.stl
30.0 x 18.2 x 5.50
