FORMBOT/Marathon_UpdateManager/5__Formbot__Usefull_3Ds/51__Spool_Holder/Spool_Holder_Roll___V1.stl

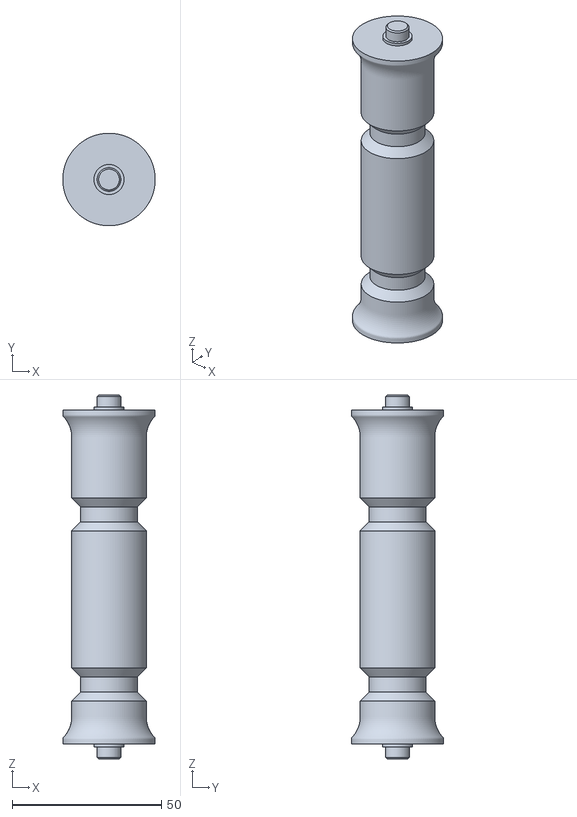
[picture p44: CAD file, 2024-05-28]
5__Formbot__Usefull_3Ds/51__Spool_Holder/Spool_Holder_Roll___V1.stl
31.0 x 31.0 x 122.0
