FORMBOT/Marathon_UpdateManager/5__Formbot__Usefull_3Ds/50__Marathon_STLs/M1B__Limiter_Fix_GT2_Y_Axis___V1.0 v3 v2.stl

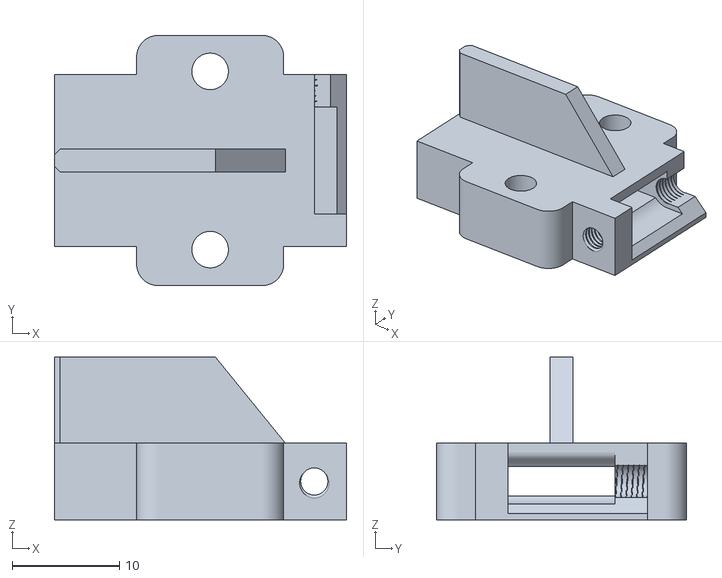
[picture p46: CAD file, 2024-05-28]
5__Formbot__Usefull_3Ds/50__Marathon_STLs/M1B__Limiter_Fix_GT2_Y_Axis___V1.0 v3 v2.stl
27.2 x 23.3 x 15.1
