FORMBOT/Marathon_UpdateManager/5__Formbot__Usefull_3Ds/51__Spool_Holder/M1B_AD__PTFE_Holder_Chamber___V1.stl

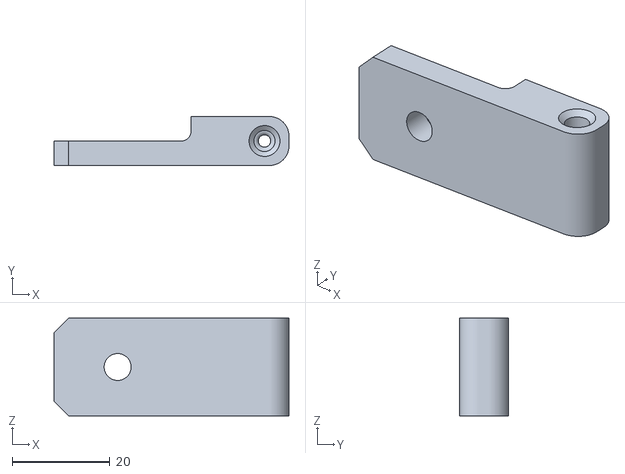
[picture p47: CAD file, 2024-05-28]
5__Formbot__Usefull_3Ds/51__Spool_Holder/M1B_AD__PTFE_Holder_Chamber___V1.stl
48.0 x 10.0 x 20.0
