FORMBOT/Marathon_UpdateManager/5__Formbot__Usefull_3Ds/50__Marathon_STLs/M1B__Pillow_Axial_Bearing_Z_Axis___V1.1 v6.stl

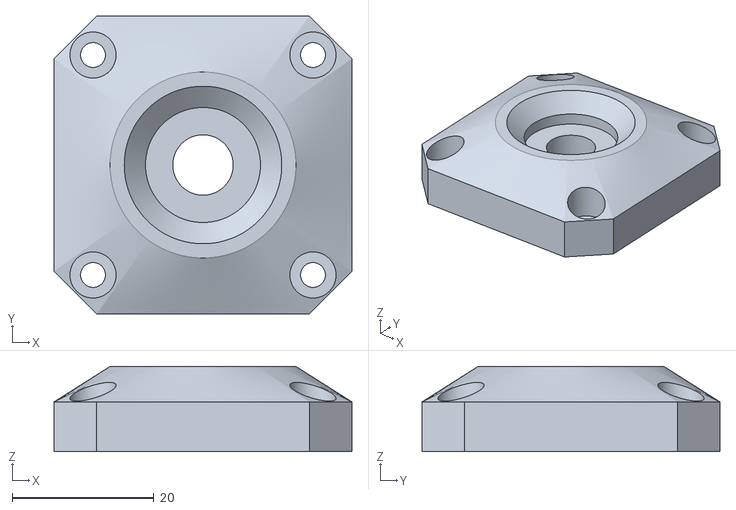
[picture p48: CAD file, 2024-05-28]
5__Formbot__Usefull_3Ds/50__Marathon_STLs/M1B__Pillow_Axial_Bearing_Z_Axis___V1.1 v6.stl
42.0 x 42.0 x 12.0
