FORMBOT/Marathon_UpdateManager/5__Formbot__Usefull_3Ds/52__Marathon_STEP_files/M1B_Offset_Hinge_4.5mm___V1.0 v4.step

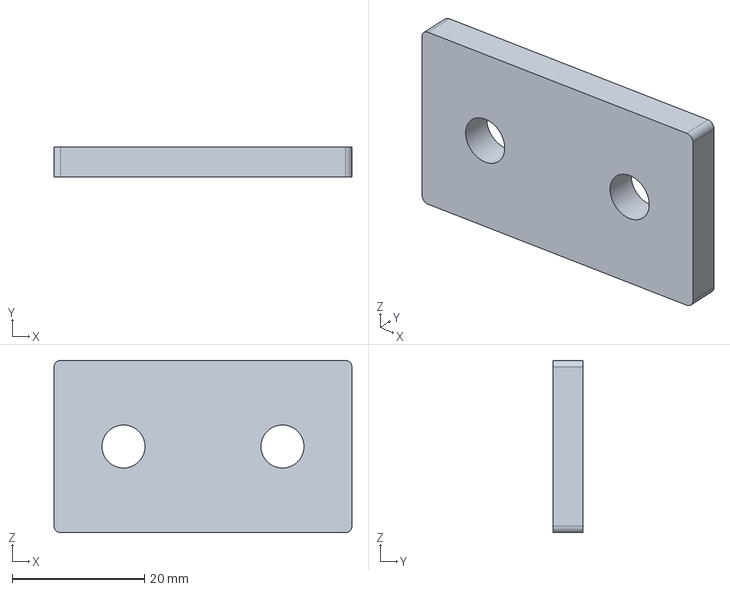
[picture p49: CAD file, 2025-07-28]
5__Formbot__Usefull_3Ds/52__Marathon_STEP_files/M1B_Offset_Hinge_4.5mm___V1.0 v4.step
45.0 x 4.50 x 26.0 mm
