FORMBOT/Marathon_UpdateManager/5__Formbot__Usefull_3Ds/50__Marathon_STLs/M1B__Cover_Print_Head_Front_T0___V2.0 v7.stl

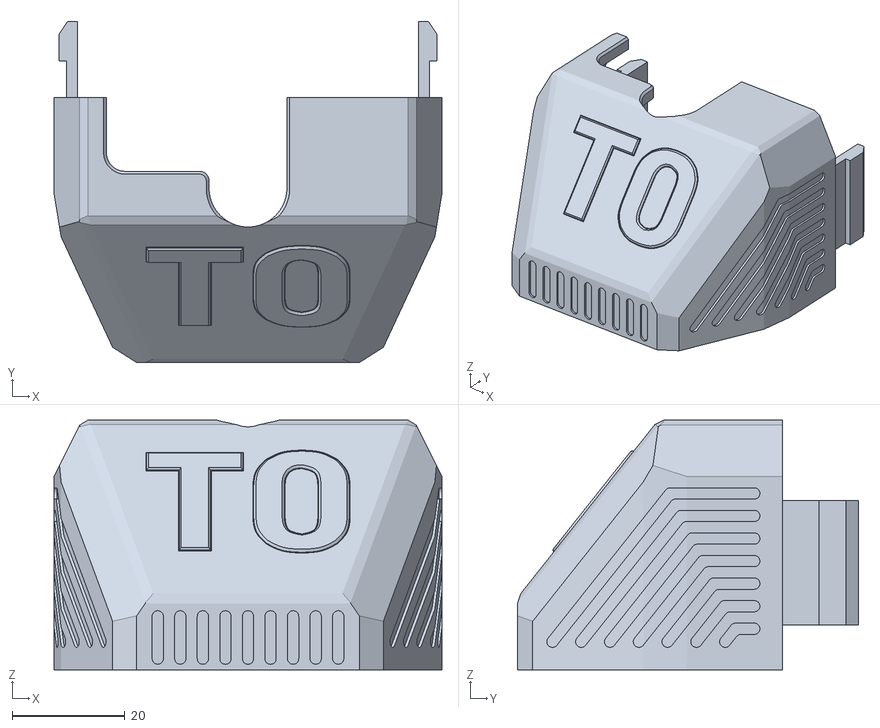
[picture p50: CAD file, 2024-05-28]
5__Formbot__Usefull_3Ds/50__Marathon_STLs/M1B__Cover_Print_Head_Front_T0___V2.0 v7.stl
68.8 x 60.5 x 44.3
