FORMBOT/Marathon_UpdateManager/5__Formbot__Usefull_3Ds/50__Marathon_STLs/M1B__Fix_Temp_Sensor_Chamber___V1.0 v4.stl

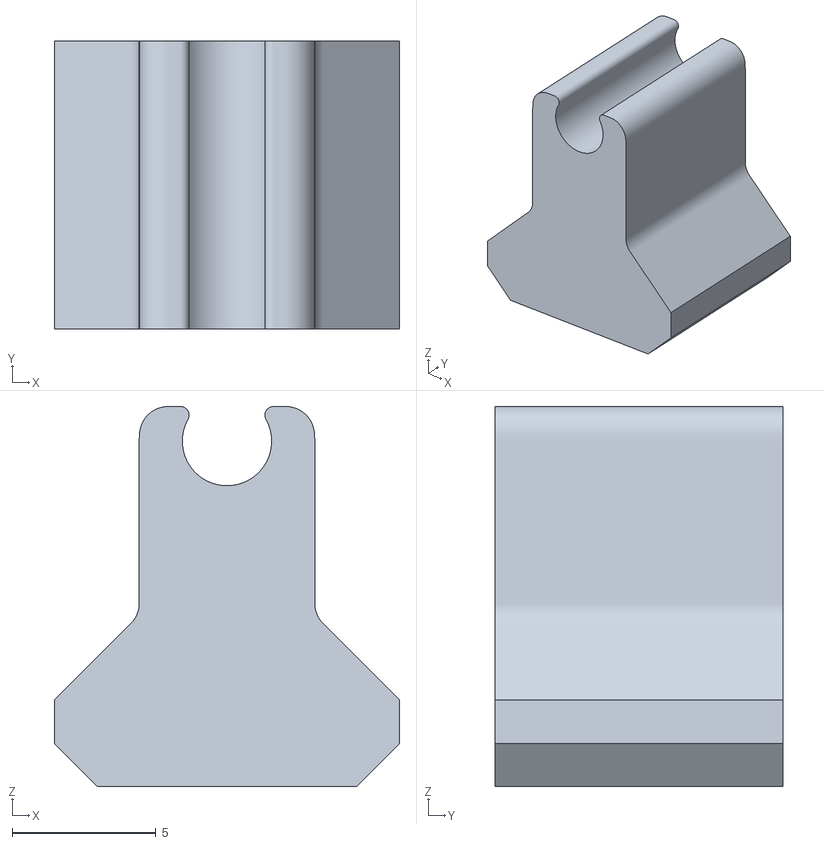
[picture p51: CAD file, 2024-05-28]
5__Formbot__Usefull_3Ds/50__Marathon_STLs/M1B__Fix_Temp_Sensor_Chamber___V1.0 v4.stl
12.0 x 10.0 x 13.2
