FORMBOT/Marathon_UpdateManager/5__Formbot__Usefull_3Ds/52__Marathon_STEP_files/M1B__Fix_PTFE_Back_Panel___V2.0.step

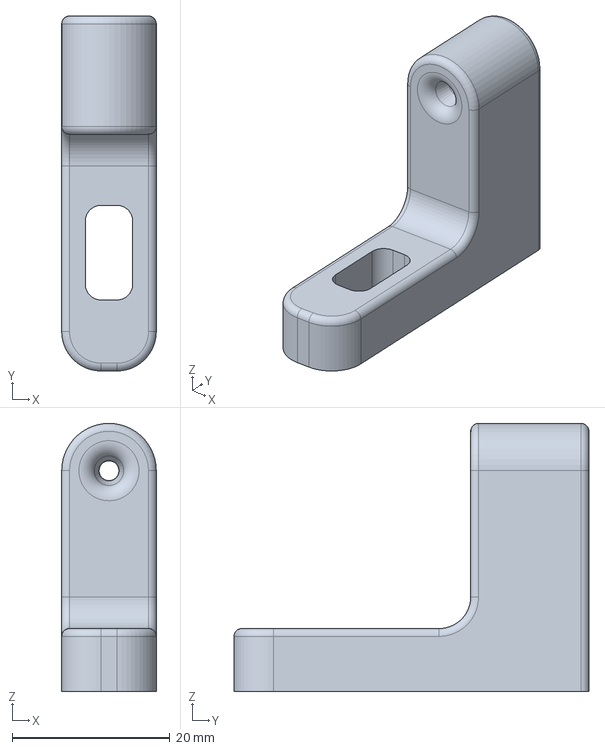
[picture p52: CAD file, 2025-07-28]
5__Formbot__Usefull_3Ds/52__Marathon_STEP_files/M1B__Fix_PTFE_Back_Panel___V2.0.step
12.0 x 45.0 x 34.0 mm
