FORMBOT/Marathon_UpdateManager/5__Formbot__Usefull_3Ds/52__Marathon_STEP_files/M1B__Cover_Print_Head_Back___V2.1.step

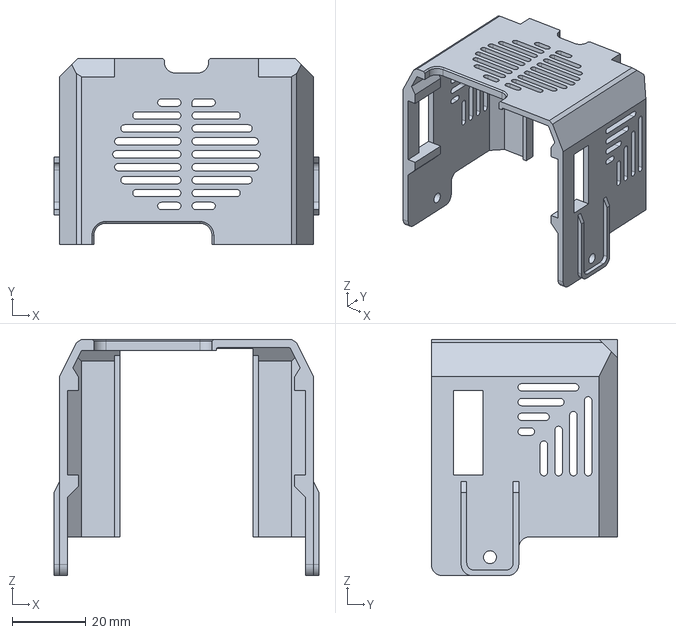
[picture p54: CAD file, 2025-07-28]
5__Formbot__Usefull_3Ds/52__Marathon_STEP_files/M1B__Cover_Print_Head_Back___V2.1.step
71.8 x 50.5 x 64.0 mm
