FORMBOT/Marathon_UpdateManager/5__Formbot__Usefull_3Ds/50__Marathon_STLs/M1B__Tensioner_GT2_Y_Axis___V1.0 v13 v2.stl

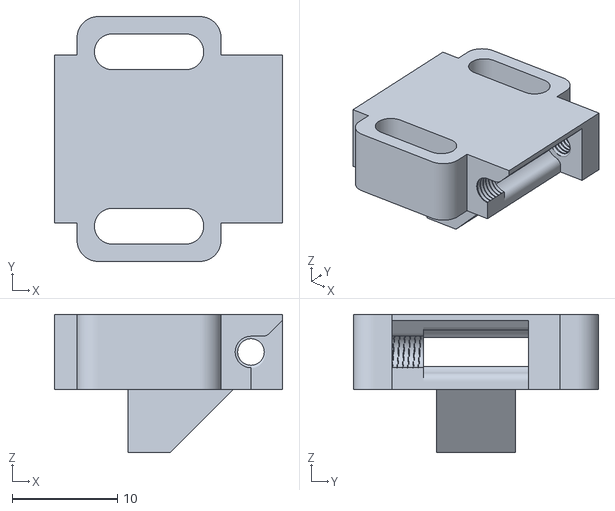
[picture p55: CAD file, 2024-05-28]
5__Formbot__Usefull_3Ds/50__Marathon_STLs/M1B__Tensioner_GT2_Y_Axis___V1.0 v13 v2.stl
21.7 x 23.3 x 13.1
