FORMBOT/Marathon_UpdateManager/5__Formbot__Usefull_3Ds/50__Marathon_STLs/M1B__WobbleX_WS12_Adapter___V2.x v5.stl

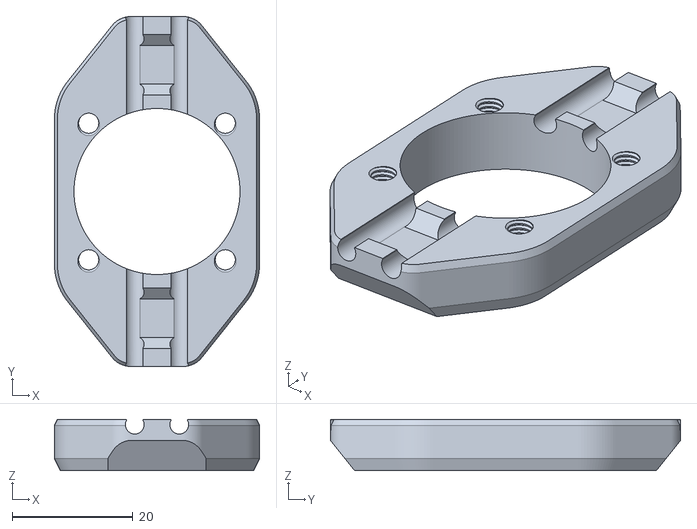
[picture p56: CAD file, 2024-05-28]
5__Formbot__Usefull_3Ds/50__Marathon_STLs/M1B__WobbleX_WS12_Adapter___V2.x v5.stl
34.0 x 58.0 x 8.50
