FORMBOT/Marathon_UpdateManager/5__Formbot__Usefull_3Ds/50__Marathon_STLs/M1B__Limiter_EndStop_X___V1.1 v2.stl

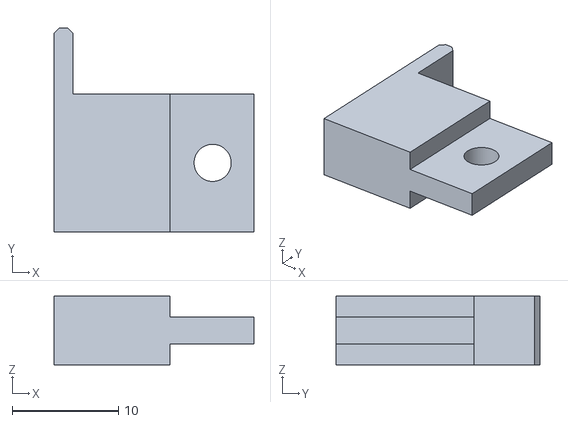
[picture p58: CAD file, 2024-05-28]
5__Formbot__Usefull_3Ds/50__Marathon_STLs/M1B__Limiter_EndStop_X___V1.1 v2.stl
18.9 x 19.2 x 6.50
