FORMBOT/Marathon_UpdateManager/5__Formbot__Usefull_3Ds/52__Marathon_STEP_files/M1B__PHead_E0_Fan_Duct___V2.0.step

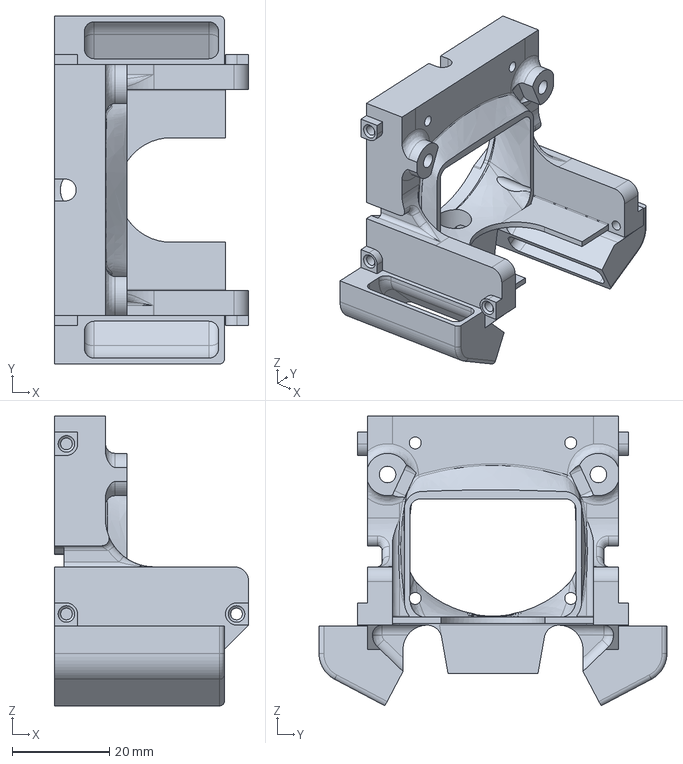
[picture p59: CAD file, 2025-07-28]
5__Formbot__Usefull_3Ds/52__Marathon_STEP_files/M1B__PHead_E0_Fan_Duct___V2.0.step
40.0 x 71.6 x 59.6 mm
