FORMBOT/Marathon_UpdateManager/5__Formbot__Usefull_3Ds/50__Marathon_STLs/M1B__Fix_GT2_Y_Axis___V2.0 v2.stl

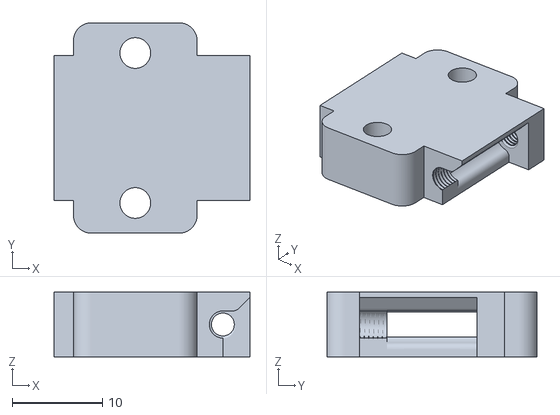
[picture p60: CAD file, 2024-05-28]
5__Formbot__Usefull_3Ds/50__Marathon_STLs/M1B__Fix_GT2_Y_Axis___V2.0 v2.stl
21.7 x 23.3 x 7.15
