FORMBOT/Marathon_UpdateManager/5__Formbot__Usefull_3Ds/52__Marathon_STEP_files/M1B_Housing_BTT_TFT35_SPI___V2.1.step

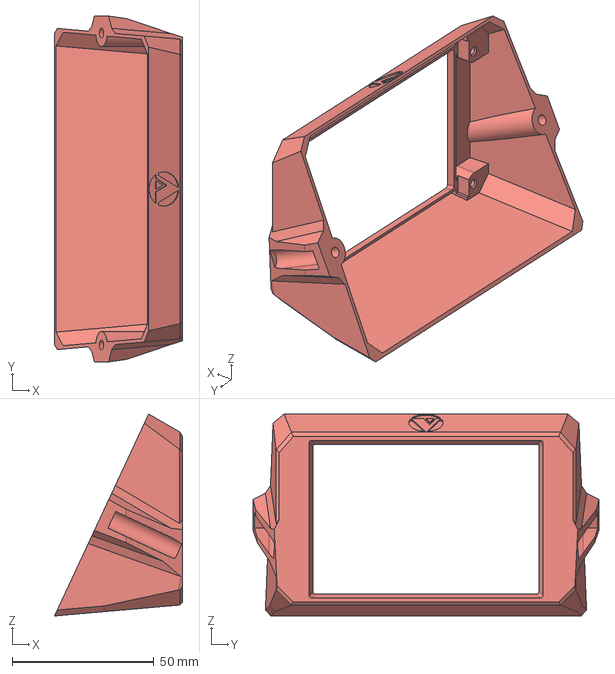
[picture p61: CAD file, 2025-07-28]
5__Formbot__Usefull_3Ds/52__Marathon_STEP_files/M1B_Housing_BTT_TFT35_SPI___V2.1.step
45.2 x 122.0 x 71.3 mm
