FORMBOT/Marathon_UpdateManager/5__Formbot__Usefull_3Ds/50__Marathon_STLs/M1B__Spool_Holer___V1.0 v8.stl

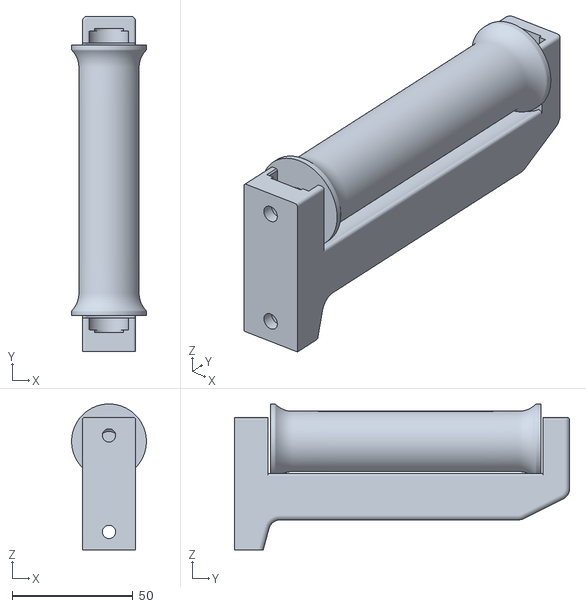
[picture p62: CAD file, 2024-05-28]
5__Formbot__Usefull_3Ds/50__Marathon_STLs/M1B__Spool_Holer___V1.0 v8.stl
31.0 x 139.0 x 60.5
