FORMBOT/Marathon_UpdateManager/5__Formbot__Usefull_3Ds/50__Marathon_STLs/M1B__Limiter_EndStop_X___V1.0 v14.stl

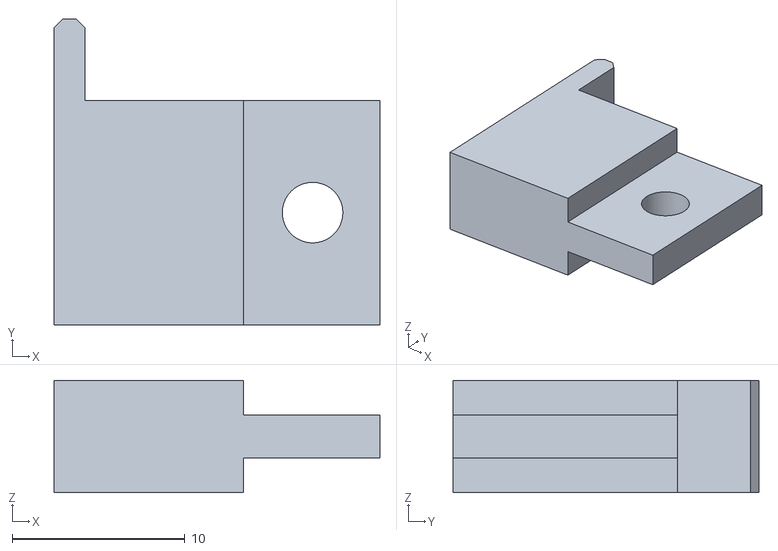
[picture p63: CAD file, 2024-05-28]
5__Formbot__Usefull_3Ds/50__Marathon_STLs/M1B__Limiter_EndStop_X___V1.0 v14.stl
18.9 x 17.7 x 6.50
