FORMBOT/Marathon_UpdateManager/5__Formbot__Usefull_3Ds/50__Marathon_STLs/M1B__Fix_Endstop_Y_axis___V2.0 v2.stl

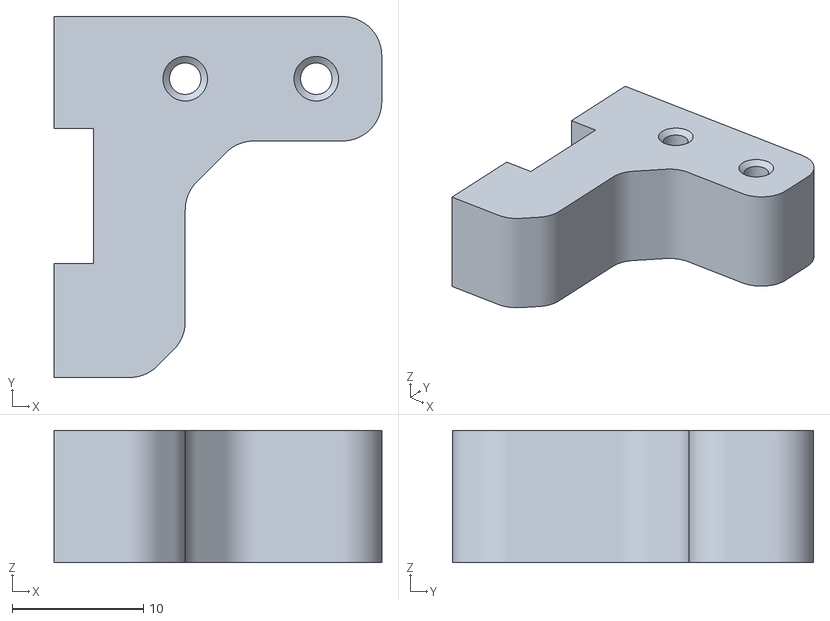
[picture p64: CAD file, 2024-05-28]
5__Formbot__Usefull_3Ds/50__Marathon_STLs/M1B__Fix_Endstop_Y_axis___V2.0 v2.stl
25.0 x 27.5 x 10.1
