FORMBOT/Marathon_UpdateManager/5__Formbot__Usefull_3Ds/50__Marathon_STLs/M1B_Offset_Hinge_3mm___V2.2 v2.stl

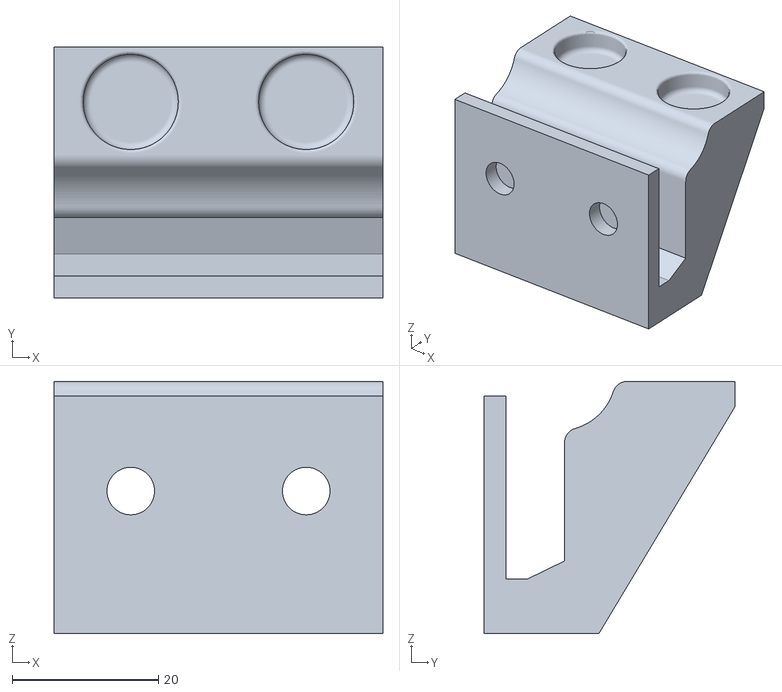
[picture p65: CAD file, 2024-05-28]
5__Formbot__Usefull_3Ds/50__Marathon_STLs/M1B_Offset_Hinge_3mm___V2.2 v2.stl
45.0 x 34.3 x 34.5
