FORMBOT/Marathon_UpdateManager/5__Formbot__Usefull_3Ds/50__Marathon_STLs/M1B__PHead_KBL_Duct___V3 v10.stl

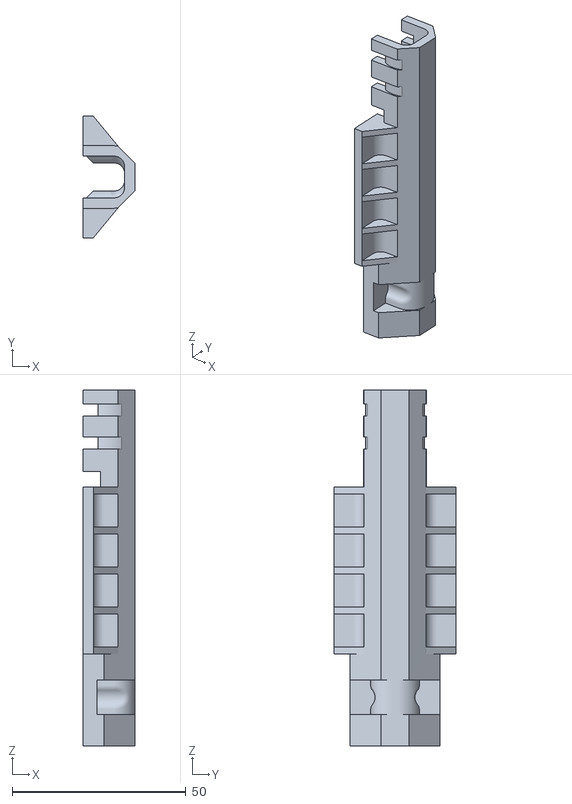
[picture p66: CAD file, 2024-05-28]
5__Formbot__Usefull_3Ds/50__Marathon_STLs/M1B__PHead_KBL_Duct___V3 v10.stl
15.0 x 35.0 x 102.5
