FORMBOT/Marathon_UpdateManager/5__Formbot__Usefull_3Ds/52__Marathon_STEP_files/M1B_Offset_Hinge_3mm___V2.2.step

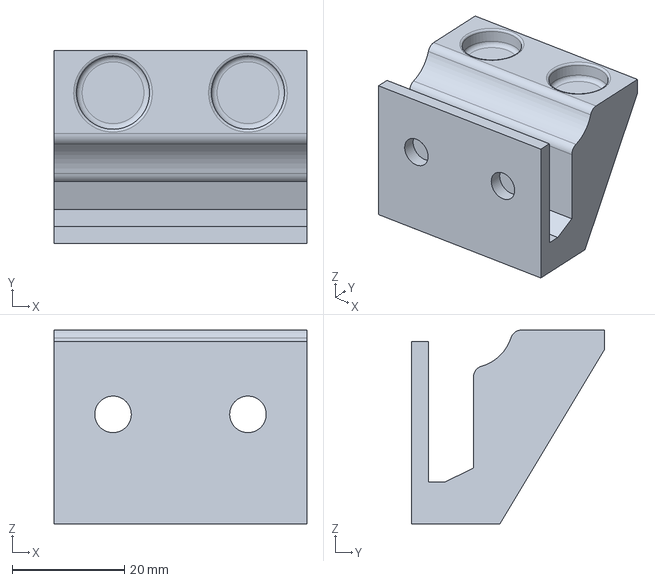
[picture p67: CAD file, 2025-07-28]
5__Formbot__Usefull_3Ds/52__Marathon_STEP_files/M1B_Offset_Hinge_3mm___V2.2.step
45.0 x 34.3 x 34.5 mm
