FORMBOT/Marathon_UpdateManager/5__Formbot__Usefull_3Ds/50__Marathon_STLs/M1B__Fixation_GT2_X_Axis___V3.0 v2.stl

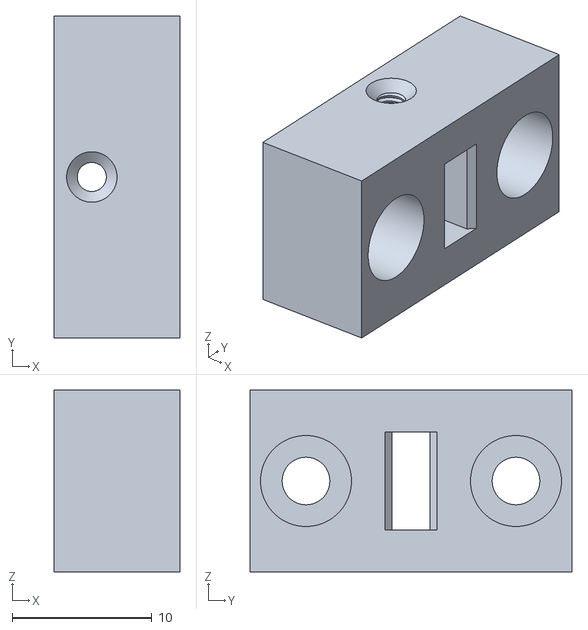
[picture p68: CAD file, 2024-05-28]
5__Formbot__Usefull_3Ds/50__Marathon_STLs/M1B__Fixation_GT2_X_Axis___V3.0 v2.stl
9.00 x 23.0 x 13.0
