FORMBOT/Marathon_UpdateManager/5__Formbot__Usefull_3Ds/52__Marathon_STEP_files/M1B_Fix_Cables_Base___V1.0.step

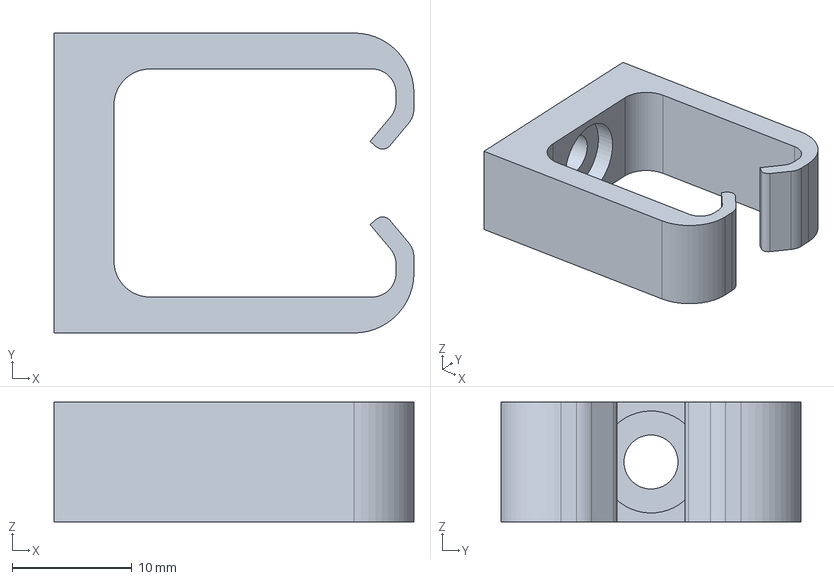
[picture p69: CAD file, 2025-07-28]
5__Formbot__Usefull_3Ds/52__Marathon_STEP_files/M1B_Fix_Cables_Base___V1.0.step
30.0 x 25.0 x 10.0 mm
