FORMBOT/Marathon_UpdateManager/5__Formbot__Usefull_3Ds/50__Marathon_STLs/M1B__WobbleX_WS12_Adapter_TOP___V1.0 v3.stl

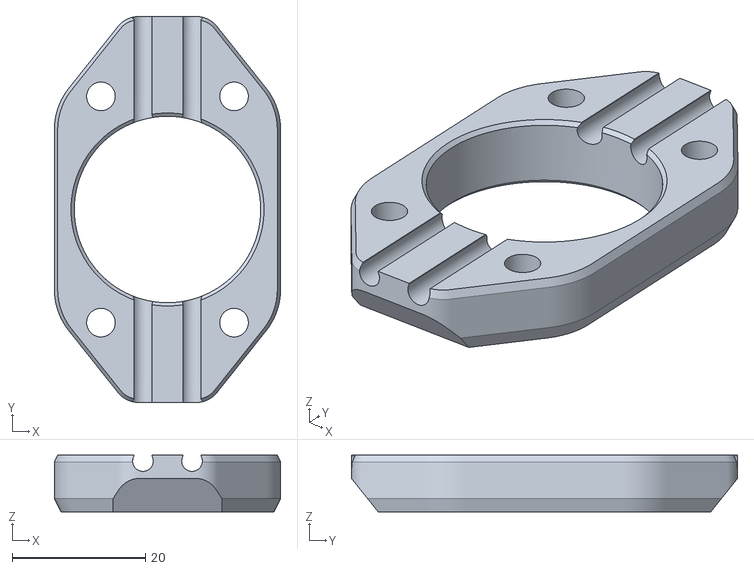
[picture p70: CAD file, 2024-05-28]
5__Formbot__Usefull_3Ds/50__Marathon_STLs/M1B__WobbleX_WS12_Adapter_TOP___V1.0 v3.stl
34.0 x 58.0 x 8.50
