FORMBOT/Marathon_UpdateManager/5__Formbot__Usefull_3Ds/52__Marathon_STEP_files/M1B__Cover_Print_Head_Front_T0_SmarS___V1.0.step

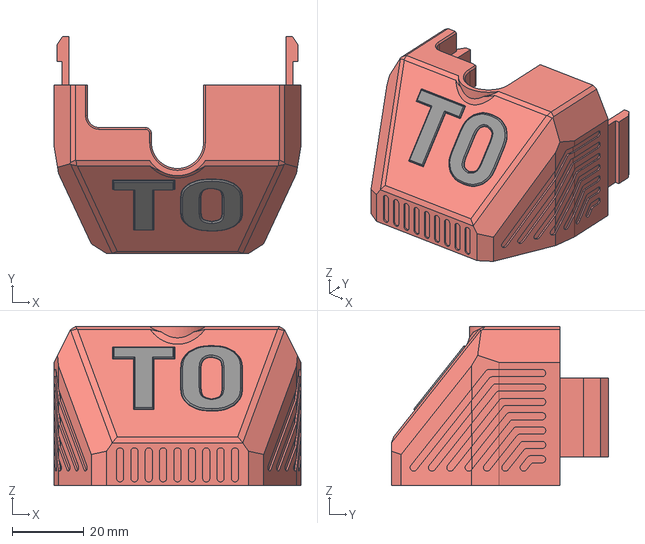
[picture p71: CAD file, 2025-07-28]
5__Formbot__Usefull_3Ds/52__Marathon_STEP_files/M1B__Cover_Print_Head_Front_T0_SmarS___V1.0.step
68.8 x 60.5 x 44.3 mm
