FORMBOT/Marathon_UpdateManager/5__Formbot__Usefull_3Ds/50__Marathon_STLs/M1B__Fron_Cover_MB_BTT_Manta_M8P___V1.1 v2 v2.stl

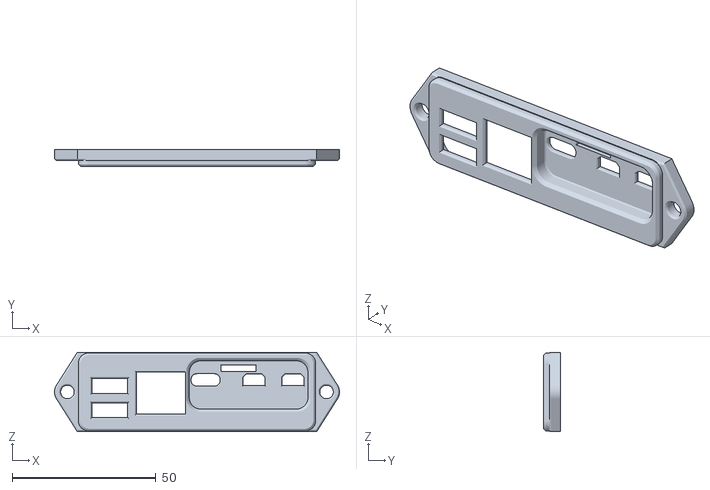
[picture p74: CAD file, 2024-05-28]
5__Formbot__Usefull_3Ds/50__Marathon_STLs/M1B__Fron_Cover_MB_BTT_Manta_M8P___V1.1 v2 v2.stl
99.2 x 6.00 x 27.6
