FORMBOT/Marathon_UpdateManager/5__Formbot__Usefull_3Ds/52__Marathon_STEP_files/M1B__Hepa_Filter_Housing___V1.0.step

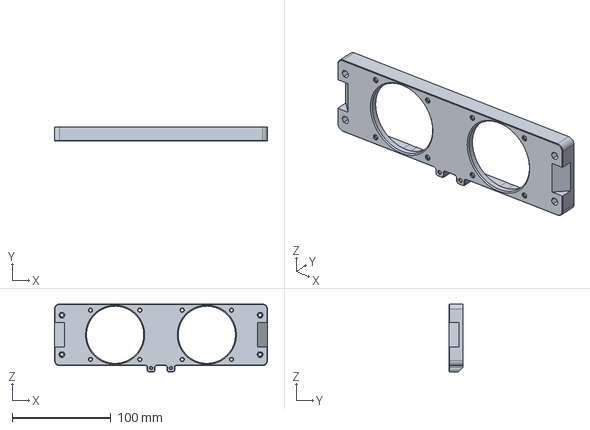
[picture p75: CAD file, 2025-07-28]
5__Formbot__Usefull_3Ds/52__Marathon_STEP_files/M1B__Hepa_Filter_Housing___V1.0.step
216.0 x 14.2 x 68.9 mm
