FORMBOT/Marathon_UpdateManager/5__Formbot__Usefull_3Ds/52__Marathon_STEP_files/M1B__PHead_KBL_Duct___V4.step

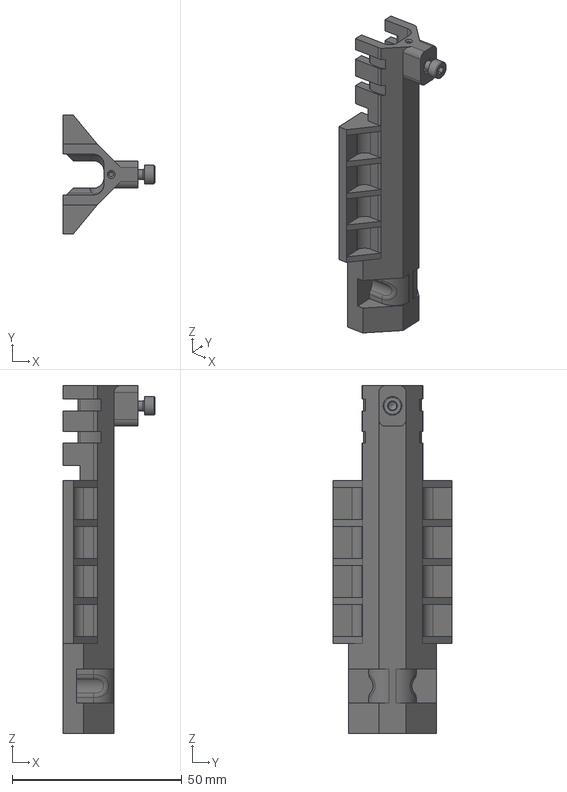
[picture p76: CAD file, 2025-07-28]
5__Formbot__Usefull_3Ds/52__Marathon_STEP_files/M1B__PHead_KBL_Duct___V4.step
27.0 x 35.0 x 102.5 mm
_WUERTH 00803 10 cylinder head screw DIN 912 M3x10 10.9 BLK
ruthex RX-M3-5,7
