FORMBOT/Marathon_UpdateManager/5__Formbot__Usefull_3Ds/52__Marathon_STEP_files/M1B__Cover_Print_Head_Back_SmartS___V1.0.step

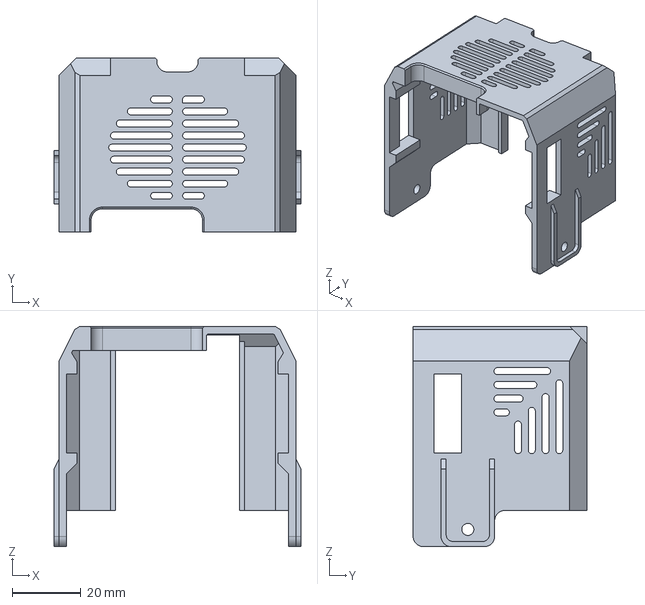
[picture p77: CAD file, 2025-07-28]
5__Formbot__Usefull_3Ds/52__Marathon_STEP_files/M1B__Cover_Print_Head_Back_SmartS___V1.0.step
71.8 x 50.5 x 64.0 mm
