FORMBOT/Marathon_UpdateManager/(list of files, cad)

Other CAD files:
5__Formbot__Usefull_3Ds/52__Marathon_STEP_files/M1B__Fix_Fan_Mainboard___V2.0.step
5__Formbot__Usefull_3Ds/50__Marathon_STLs/M1B__Fix_Fan_Mainboard___V2.0 v6.stl
5__Formbot__Usefull_3Ds/52__Marathon_STEP_files/M1B_Fix_Wipe_Plate_Nozzle_Left__V2.0.step
5__Formbot__Usefull_3Ds/52__Marathon_STEP_files/M1B__WobbleX_WS12_Adapter___V2.x.step
5__Formbot__Usefull_3Ds/52__Marathon_STEP_files/M1B__Tensioner_GT2_Y_Axis___V1.0 v13.step
5__Formbot__Usefull_3Ds/50__Marathon_STLs/M1B__Cover_Print_Head_Front_T1___V2.0 v3.stl
5__Formbot__Usefull_3Ds/52__Marathon_STEP_files/M1B_Fix_Bearing_GE5C___V1.0.step
5__Formbot__Usefull_3Ds/52__Marathon_STEP_files/M1B__Cover_Print_Head_Front_T0___V2.0.step
5__Formbot__Usefull_3Ds/50__Marathon_STLs/M1B_Offset_Hinge_4.5mm___V1.0 v4.stl
5__Formbot__Usefull_3Ds/52__Marathon_STEP_files/M1B__Fix_Endstop_Y_axis___V2.0.step
5__Formbot__Usefull_3Ds/52__Marathon_STEP_files/M1B__Pillow_Axial_Bearing_Z_Axis___V1.1.step
5__Formbot__Usefull_3Ds/50__Marathon_STLs/M1B__Cover_Print_Head_Back___V2.1 v3.stl
5__Formbot__Usefull_3Ds/50__Marathon_STLs/M1B_Fix_Wipe_Plate_Nozzle_Right__V2.0 v2.stl
5__Formbot__Usefull_3Ds/52__Marathon_STEP_files/M1B__Fix_Temp_Sensor_Chamber___V1.0.step
5__Formbot__Usefull_3Ds/52__Marathon_STEP_files/M1B__Limiter_EndStop_X___V1.1.step
5__Formbot__Usefull_3Ds/50__Marathon_STLs/M1B_Fix_Cables_Base___V1.0 v5.stl
5__Formbot__Usefull_3Ds/52__Marathon_STEP_files/M1B__Fron_Cover_MB_BTT_Manta_M8P___V1.1.step
5__Formbot__Usefull_3Ds/50__Marathon_STLs/M1B__PHead_E0_Fan_Duct___V2.0 v2.stl
5__Formbot__Usefull_3Ds/52__Marathon_STEP_files/M1B__WobbleX_WS12_Adapter_TOP___V1.0.step
5__Formbot__Usefull_3Ds/52__Marathon_STEP_files/M1B_Fix_Wipe_Plate_Nozzle_Right__V2.0.step
5__Formbot__Usefull_3Ds/52__Marathon_STEP_files/M1B__Fix_GT2_Y_Axis___V2.0.step
5__Formbot__Usefull_3Ds/50__Marathon_STLs/M1B_Housing_BTT_TFT35_SPI___V2.1 v2.stl
5__Formbot__Usefull_3Ds/52__Marathon_STEP_files/M1B__Cover_Print_Head_Front_T1___V2.0.step
5__Formbot__Usefull_3Ds/50__Marathon_STLs/M1B__PHead_E1_Fan_Duct___V2.0 v2.stl
5__Formbot__Usefull_3Ds/50__Marathon_STLs/M1B__Fix_PTFE_Back_Panel___V2.0 v2.stl
5__Formbot__Usefull_3Ds/52__Marathon_STEP_files/M1B__Spool_Holer___V1.0.step
5__Formbot__Usefull_3Ds/52__Marathon_STEP_files/M1B__Fixation_GT2_X_Axis___V3.0.step
5__Formbot__Usefull_3Ds/52__Marathon_STEP_files/M1B__Limiter_Fix_GT2_Y_Axis___V1.0.step
5__Formbot__Usefull_3Ds/50__Marathon_STLs/M1B__Upper_Support_Lead_Screw_Back___V4.0 v2.stl
5__Formbot__Usefull_3Ds/50__Marathon_STLs/M1B__Upper_Support_Lead_Screw_Left___V3.0 v3.stl
5__Formbot__Usefull_3Ds/50__Marathon_STLs/M1B__Upper_Support_Lead_Screw_Right___V3.0 v2.stl
5__Formbot__Usefull_3Ds/52__Marathon_STEP_files/M1B__Fix_Corrugated_Tube___V3.0.step
5__Formbot__Usefull_3Ds/52__Marathon_STEP_files/M1B__PHead_KBL_Duct___V3.step
5__Formbot__Usefull_3Ds/52__Marathon_STEP_files/M1B__Upper_Support_Lead_Screw_Back___V4.0.step
5__Formbot__Usefull_3Ds/52__Marathon_STEP_files/M1B__Upper_Support_Lead_Screw_Left___V3.0.step
5__Formbot__Usefull_3Ds/52__Marathon_STEP_files/M1B__Upper_Support_Lead_Screw_Right___V3.0.step
