FORMBOT/Marathon_UpdateManager/3__Formbot_SlicerProfiles/31__PrusaSlicer/01_01082024/printer/Texture_printbed_marathon-MONO_Dual.png

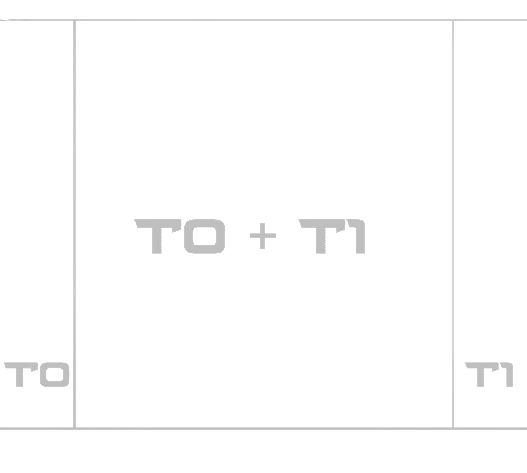
3__Formbot_SlicerProfiles/31__PrusaSlicer/01_01082024/printer/Texture_printbed_marathon-MONO_Dual.png
