FORMBOT/Marathon_UpdateManager/3__Formbot_SlicerProfiles/31__PrusaSlicer/01_01082024/printer/Texture_printbed_marathon_MIRROR_Slicer.png

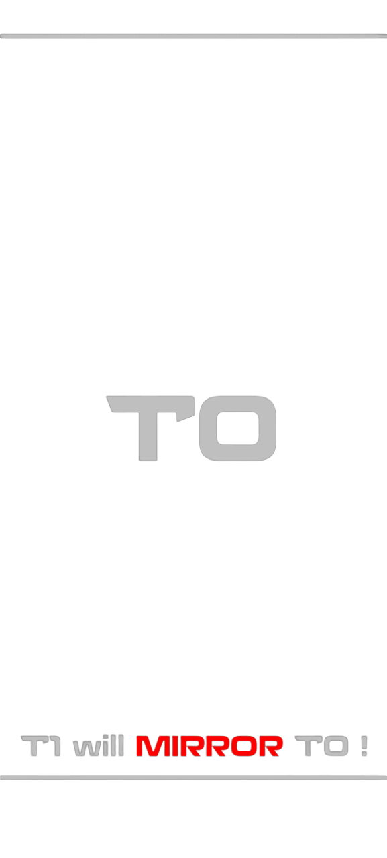
3__Formbot_SlicerProfiles/31__PrusaSlicer/01_01082024/printer/Texture_printbed_marathon_MIRROR_Slicer.png
