FORMBOT/Marathon_UpdateManager/(threads)

Thread 2 (2024-11-25):

Unable to move bed up when using the Print Heads Z Leveling macro.

co-nan, 2024-11-25:
When performing the print head z leveling you are unable to move up like is says to do in the instructions.  The option is greyed out.  The only way to perform the z leveling is to home all and then select mirror mode.  Once mirror mode is selected you can move the heads with a main sail command, then perform the rest of the z leveling.  There is an issue with the macro.  I tried removing the M84 thinking the disabling the stepper may cause klipper to requite a homing before any movement command as all movement commands are greyed out in mainsail.

Thread 3 (2024-11-30):

Smart Sensor T1 Copy_Mirror mode

vzagranichnyy, 2024-11-30:
In duplicate and mirror printing mode, the head 1 filament sensor does not work correctly
It pauses, but does not unload the remaining piece of filament
When loading a new filament and unpausing, head 1 remains active and printing occurs with an inactive extruder 0
