FORMBOT/Marathon_UpdateManager/(commit log)

2024-05-28 Files Transfer from Dan3dp to Formbot
    [025_01__MB1__Fix_CXC_Bed___V1.0 v17.step, M1B_AD__PTFE_Holder_Chamber___V1.stl, M1B_Fix_Bearing_GE5C___V1.0 v2.stl, M1B_Fix_Cables_Base___V1.0 v5.stl, M1B_Fix_Wipe_Plate_Nozzle_Left__V2.0 v2.stl, M1B_Fix_Wipe_Plate_Nozzle_Right__V2.0 v2.stl, M1B_Housing_BTT_TFT35_SPI___V2.1 v2.stl, M1B_Offset_Hinge_3mm___V2.2 v2.stl]
2024-06-09 Homing Speeds adjust
    [M1__Printer_Specs__Formbot.cfg, M1__X1_Axis__Formbot.cfg, M1__X2_Axis__Formbot.cfg, M1__Y_Axis__Formbot.cfg, M1__Z_Axis__Formbot.cfg]
2024-06-10 Activate extruder/*1 before load/unload
    [M1_T0_Sensor_Formbot.cfg, M1_T1_Sensor_Formbot.cfg]
2024-06-10 Slicer & BTT HDMI5
    [STL_Marathon_BED_Copy.stl, STL_Marathon_BED_Mirror.stl, STL_Marathon_BED_Mono_Dual.stl]
2024-06-22 MB_Controlled fan added
    [M1B__Fix_Fan_Mainboard___V2.0 v6.step, M1__Temp_Control__MB_Fan.cfg]
2024-06-22 save variables with negative sign
    [M1__Auto_XY_Calibration__Formbot.cfg]
2024-06-22 negative inside curly bracket
    [M1__Auto_XY_Calibration__Formbot.cfg, M1__kTAMV_CXC_Macros__Formbot.cfg]
2024-06-29 Update 0.2mm 0.4nozzle SPEED @Marathon.ini
2024-07-02 exclude object; purge line
    [STL_Marathon_BED_Copy.stl, STL_Marathon_BED_Mirror.stl, STL_Marathon_BED_Mono_Dual.stl]
2024-07-24 PID Control for print bed
    [M1__PrintBed___Formbot.cfg]
2024-08-02 update ABS, PETG Filament profile
    [STL_Marathon_BED_Copy.stl, STL_Marathon_BED_Mirror.stl, STL_Marathon_BED_Mono_Dual.stl]
2024-11-22 implementation of Smart Orbiter Sensor
    [M1.1_SmartSensor_T0.cfg, M1.1_SmartSensor_T1.cfg, M1.1__Formbot_Marathon.cfg]
2024-11-22 smartsensor cfg update
    [M1.1_SmartSensor_T0.cfg, M1.1_SmartSensor_T1.cfg]
2024-11-22 SmartSensort cfg update
    [M1.1_SmartSensor_T0.cfg, M1.1_SmartSensor_T1.cfg]
2024-11-22 SmartSensor.cfg update
    [M1.1_SmartSensor_T0.cfg, M1.1_SmartSensor_T1.cfg]
2024-11-22 SmartSensor Fil.Tangle
    [M1.1_SmartSensor_T0.cfg, M1.1_SmartSensor_T1.cfg]
2024-11-22 M600 instead of PAUSE
    [M1.1_SmartSensor_T0.cfg, M1.1_SmartSensor_T1.cfg]
2024-11-23 unload tangle
    [M1.1_SmartSensor_T0.cfg, M1.1_SmartSensor_T1.cfg]
2024-11-23 cfg updates
    [M1.1_SmartSensor_T0.cfg, M1.1_SmartSensor_T1.cfg, M1.1__Formbot_Marathon.cfg, M1__Printer_Macros___Formbot.cfg]
2024-11-24 load SmartSensor
    [M1.1_SmartSensor_T0.cfg, M1.1_SmartSensor_T1.cfg]
2024-12-12 SmartSensor config update
    [M1.1_SmartSensor_T0.cfg, M1.1_SmartSensor_T1.cfg]
2024-12-14 update Orbiter Sensor CFG
    [M1_T0_Sensor_Formbot.cfg, M1_T1_Sensor_Formbot.cfg]
2025-04-26 insert of py modules
2025-07-13 stealthchop_threshold: 0 and run_current: 0.90
    [M1__X1_Axis__Formbot.cfg, M1__X2_Axis__Formbot.cfg]
2025-07-28 Step files for Marathon plastic parts
    [M1B_Fix_Bearing_GE5C___V1.0.step, M1B_Fix_Cables_Base___V1.0.step, M1B_Fix_Wipe_Plate_Nozzle_Left__V2.0.step, M1B_Fix_Wipe_Plate_Nozzle_Right__V2.0.step, M1B_Housing_BTT_TFT35_SPI___V2.1.step, M1B_Offset_Hinge_3mm___V2.2.step, M1B_Offset_Hinge_4.5mm___V1.0 v4.step, M1B__Cover_Print_Head_Back_SmartS___V1.0.step]
